cdn/Polyformer/README.md

# Polyformer
## To Reshape, Recreate, Reproduce.

Polyformer is an open-source project that aims to recycle plastics into FDM filaments

Join the Discord by signing up $1 Github sponsorship or $1 Patreon, Link is on the right

Hero_34

Opening_Animation

[Project Page](http://www.reiten.design/polyformer)
