cdn/Polyformer/Electronics/README.md

# Firmware Setup

### Its a good idea to flash the firmware for Pi and MCU **BEFORE** you follow the part 4 video and install them on the machine.

## Option1: (Klipper: Standalone Pi + Compatible MCU)

- Insert SD card into your PC, download and install Pios on the SD card. [Download Pios here](https://www.raspberrypi.com/software/)
- Before you install the OS, please configure your pi's username, password, and network(SSIDs are upper case sensitive!!!) in the setting.
- It takes sometime if the Pi is first time booting up upon an install. Please be patient for 5 minutes and 5 minutes only.



## Klipper installation on Raspberry

First, you’ll need a SSH client such as [PuTTY](https://www.putty.org/) or use your PC’s terminal. We’ll use it to
connect our PC to the Raspberry.

- Start with locating Raspberry in your local network.

  - You can use [Advanced IP Scanner](https://www.advanced-ip-scanner.com/) to find it.

  

  - Or if you can plug a keyboard, a mouse, and a screen to your Raspberry:

    - Once plugged, turn the Raspberry on and wait until the main screen appears
    - Click on the terminal icon on the task bar

    

    - Type `ifconfig` and find the IP address between 192.168.0.1-254 or 192.168.1.1-254

    

- SSH connection

  - If you chose PuTTY, paste the copied IP from the previous step. Click on Open.

  

  - This window may appear, click on Yes

  

  - Then login in the terminal with your username and password.

  * Else, if you chose your PC’s terminal, you can type `ssh pi@192.168.0.210` to connect to the Raspberry ((replace pi by the username you set on Raspberry Setup and the IP by the one you found on the previous step) and type your password.

- GIT installation

  - Type `sudo apt-get install git -y` in the terminal (you might be asked to enter your password)
  - Once the installation is complete, do the followind commands:

    - `cd ~`
    - `git clone https://github.com/th33xitus/kiauh.git`
    - `./kiauh/kiauh.sh`
    - This window will show up

    

    - Use the interface to install Klipper, Moonraker and Mainsail.

## Klipper installation on SKR Pico

If you can't get Klipper working with the UART in Option 2, try the USN which should be easier.

- Option 1 : USB setup



- Option 2 : UART setup



- Build firmware image

   1. SSH into your pi and type
      ```
      cd ~/klipper/
      make menuconfig
      ```

   2. Building the micro controller with the configuration shown below.
      * [*] Enable extra low-level configuration options
      * Micro-controller Architecture = `Raspberry Pi RP2040`
      * IF USE USB
         * Communication interface = `USB`
             klipper_menuconfig
      * ElSE IF USE UART0
         * Communication interface = `Serial (on UART0 GPIO1/GPIO0)`
             

   3. Once the configuration is selected, press `q` to exit,  and "Yes" when  asked to save the configuration.
   4. Run the command `make`
   5. The `klipper.uf2` file will be generated in the folder `home/pi/kliiper/out` when the `make` command completed. Use your windows PC to copy the file from the Pi's folder using [winscp](https://winscp.net/download/WinSCP-5.21.1-Setup.exe) to your PC.

## Firmware Installation

1. Insert a jumper on the `Boot` pins of the motherboard and click the `Reset` button to enter the burn mode (Note: If you want to use USB to power the motherboard, you need to insert a jumper on `USB Power`. When there is 12V / 24V power supply, it is best to remove the jumper)
   boot
2. Connect USB-C to computer, then you will see a USB flash drive named `RPI-PR2`, copy `klipper.uf2` compiled by yourself to the USB flash drive, the motherboard will automatically reboot and update the firmware, the computer will re-identify this USB flash drive means the firmware update
is complete, unplug the `boot jumper` and click the `Reset` button to enter normal working mode

   msc 
3. **(note: this test is only needed for USB configuration)** you can confirm that the flash was successful, by running `ls /dev/serial/by-id`.  if the flash was successful, this should now show a klipper device, similar to:

   rp2040_id

## Configure the printer parameters
### Basic configuration
1. On your PC, open a web browser and go to the IP address we gained for SSH within the same network to access Mainsail.
2. Replace the printer.cfg file from the mainsail interface with [printer.cfg](https://github.com/Reiten966/Polyformer/blob/main/Electronics/Firmware/printer.cfg).
3. If you use USB to communicate with raspberry pi, ssh into the pi and run the `ls /dev/serial/by-id/*` command in raspberry pi to get the correct ID number of the motherboard, and set the correct ID number in `printer.cfg`. And wiring reference [here](#raspberry-pi-is-powered-by-an-external-5v-adapter-and-communicates-with-skr-pico-v10-via-usb)
    ```
    [mcu]
    serial: /dev/serial/by-id/usb-Klipper_rp2040_E66094A027831922-if00
    ```
4. If you use UART0 to communicate with raspberry pi, you need to modify the following files by inserting the SD card into the computer or by SSH command. And wiring reference [here](#raspberry-pi-is-powered-by-the-motherboard-5v-and-communicates-with-skr-pico-v10-via-uart)
   * Remove `console=serial0,115200` in `/boot/cmdline.txt`
   * Add `dtoverlay=pi3-miniuart-bt` at the end of file `/boot/config.txt`
   * Modify the configuration of `[mcu]` in `printer.cfg` to `serial: /dev/ttyAMA0` and enable `restart_method: command` by SSH
     ```
     [mcu]
     serial: /dev/ttyAMA0
     restart_method: command
     ```

## Option2: (Klipper: Voron printer + Compatible MCU)

- Plug the SKR pico to the pi via USB on your printer, and add the polyformer.cfg into your printer's config as below
  
- And then include the polyformer.cfg in your main printer.cfg as below
  

- Follow the Klipper installation on SKR Pico above.

## Option3: (Marlin: Compatible MCU + Screen)

Guide in progress, please ask in the discord.

# Wiring Guide

- UART setup
  Polyformer-Electronics-RPi-SKR-Pico1 0

- USB setup
  

# PID Calibration Procedure

This procedure is for calibrating the heater cartridge.

**Reference documentation**

- [Bigtree SKR Pico v1.0 + RPi setup](https://3dwork.io/en/skr-pico-analysis-and-complete-guide-of-this-great-little-controller)
- [Basic Klipper Configuration](https://3dwork.io/en/skr-pico-analysis-and-complete-guide-of-this-great-little-controller/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)
- [Mainsail](https://docs.mainsail.xyz/)
- [Installing MainsailOS](https://docs.mainsail.xyz/setup/mainsail-os)
- [Klipper3D](https://www.klipper3d.org)

## Pre-reqs

The following instructions assume the following:

- Your hardware setup matches the diagram the provided diagram `Polyformer-Electronics-RPi-SKR-Pico1.0-Working.png`
- Your RaspberryPi has been configured for UART integration. If not, follow this guide [Basic Klipper Configuration](https://3dwork.io/en/skr-pico-analysis-and-complete-guide-of-this-great-little-controller/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)
- _MainsailOS_ (_Mainsail_, _klipper_, and _Moonracker_) are install and running on the _RaspberryPi_
- Your _SKR Pico v1.0_ control board has been flashed with the latest stable firmware and has `UART` support. The name of your firware image should be `klipper-UART0.uf2`
- You are using the attached klipper config `printer.cfg`
- _Mainsail_ web UI is acceesible and there are no errors reported by klipper on the _Mainsail_ dashboard.

**IMPORTANT:** ALL pre-qeqs MUST be satified in order to proceed.

## Instructions

1. Open a web brower and go to the Mainsail website that is running on your RapsberryPi
2. Open the _G-Code console_ on the Mainsail web UI
3. Run the following g-code command to calibrate. This will take about 5 minutes to complete:

```
PID_CALIBRATE HEATER=extruder TARGET=210
```

4. Run this command to save the PID calibration coeffs to the 'printer.cfg' file

```
SAVE_CONFIG
```

5. Click the _Save and Restart_ button to reconfigure _Klipper_
6. Verify temperature stabiity
