cdn/Polyformer/User_Mods/cn#4916/8mm_Bottle_Cap/Bottle_Cap.png

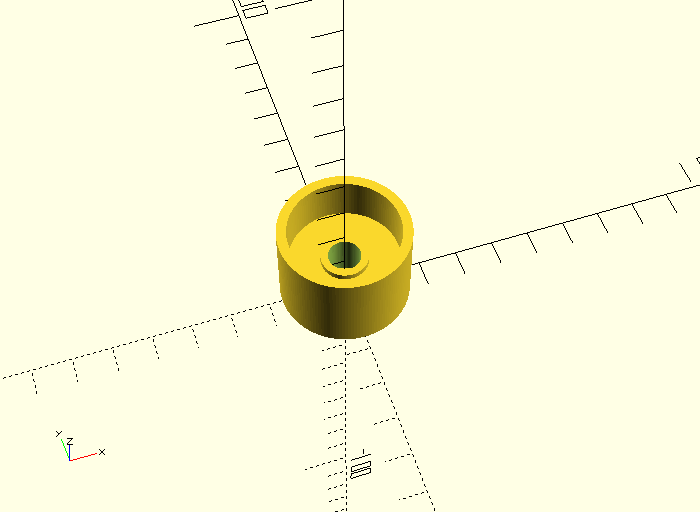
User_Mods/cn#4916/8mm_Bottle_Cap/Bottle_Cap.png
