cdn/Polyformer/STL/Bottle_Cutter (no supports)/Cutter.stl

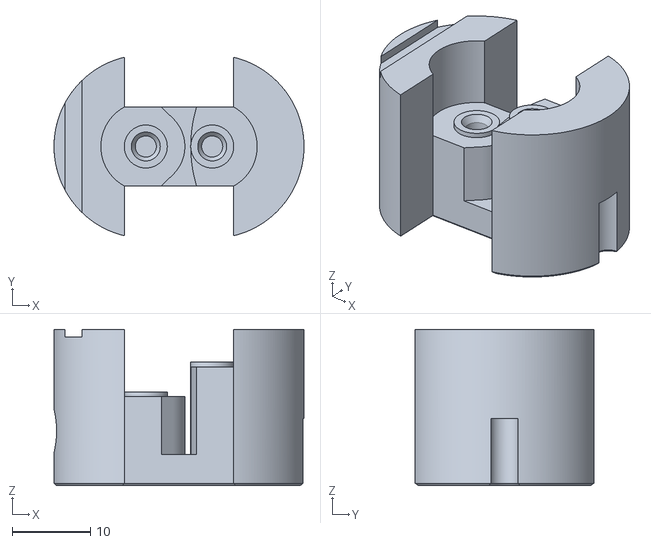
[picture p2: CAD file, 2022-08-05]
STL/Bottle_Cutter (no supports)/Cutter.stl
32.0 x 22.8 x 20.0
