cdn/Polyformer/STL/Carriages_(no supports unless noted)/Ribbon_Cartridge_Cap_2x.stl

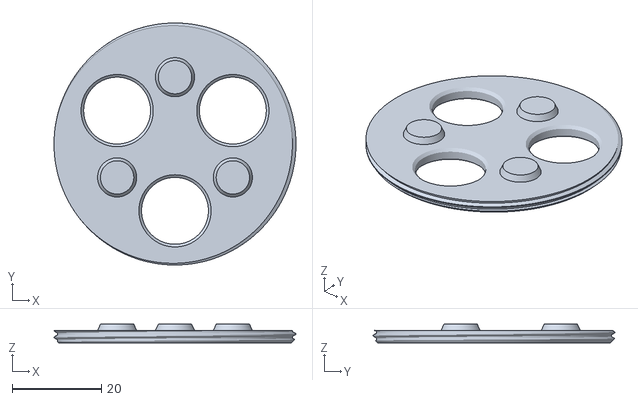
[picture p3: CAD file, 2022-08-05]
STL/Carriages_(no supports unless noted)/Ribbon_Cartridge_Cap_2x.stl
54.3 x 54.3 x 4.20
