cdn/Polyformer/STL/Gearbox (no supports)/Gear_Box_Output_Gear.stl

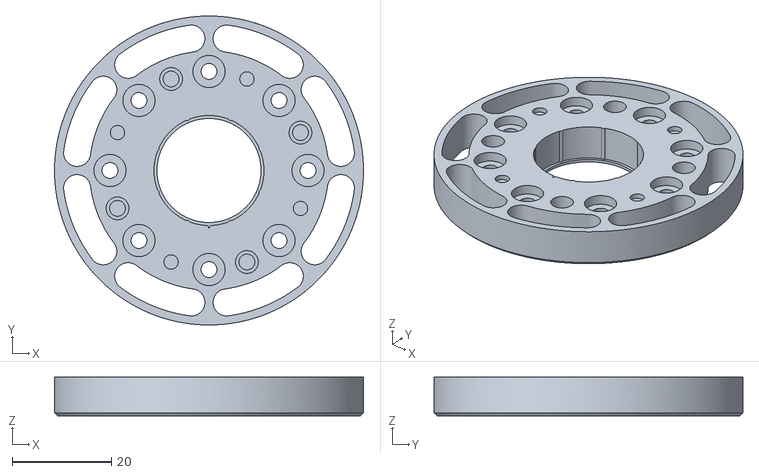
[picture p4: CAD file, 2022-08-05]
STL/Gearbox (no supports)/Gear_Box_Output_Gear.stl
62.4 x 62.4 x 7.80
