cdn/Polyformer/STL/Main_Body (no supports unless noted)/Right_Upper_Arm.stl

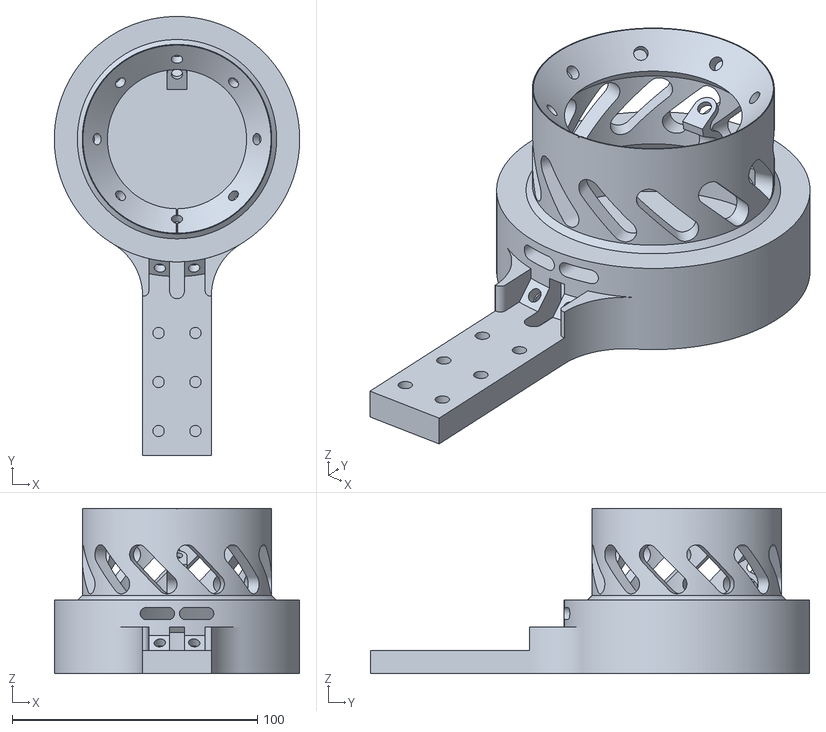
[picture p5: CAD file, 2022-08-05]
STL/Main_Body (no supports unless noted)/Right_Upper_Arm.stl
100.0 x 178.9 x 67.3
