cdn/Polyformer/STL/Panels (no supports unless noted)/Panel_Locks_x8.stl

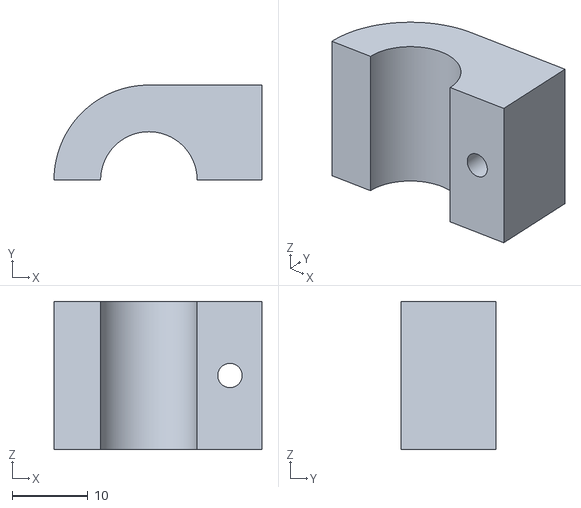
[picture p6: CAD file, 2022-08-05]
STL/Panels (no supports unless noted)/Panel_Locks_x8.stl
27.4 x 12.5 x 19.5
