cdn/Polyformer/STL/Spool (no supports)/[Accent Color] Filament_Mount_Spool_Side.stl

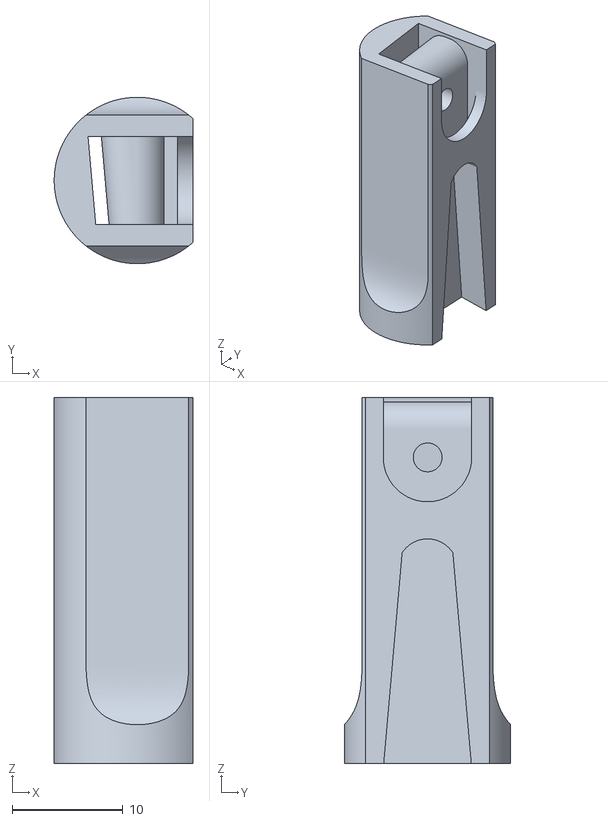
[picture p7: CAD file, 2022-08-05]
STL/Spool (no supports)/[Accent Color] Filament_Mount_Spool_Side.stl
12.5 x 15.0 x 33.0
