cdn/Polyformer/STL/Tools/PolyCube.STL

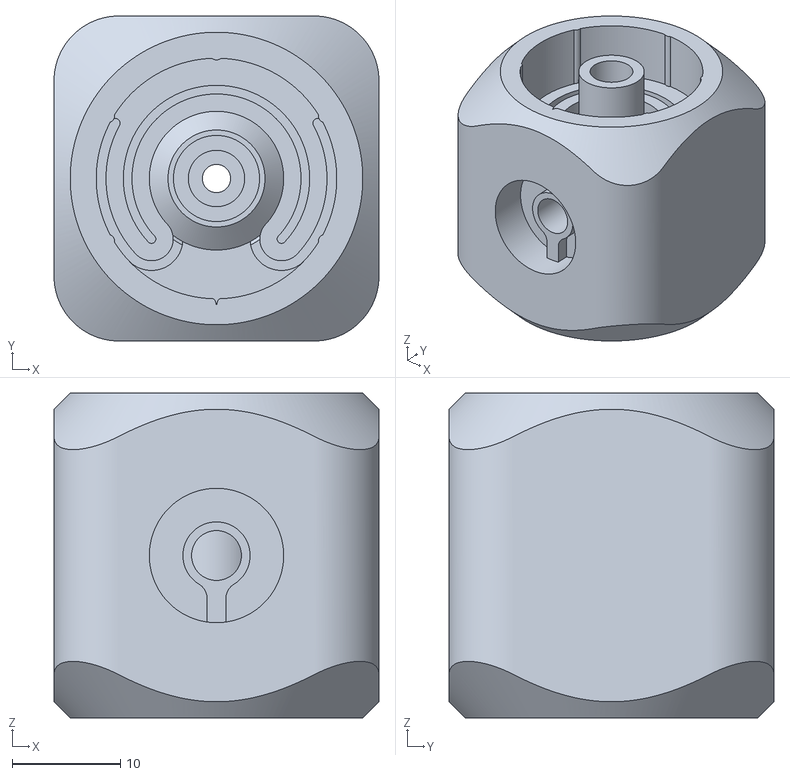
[picture p8: CAD file, 2022-07-15]
STL/Tools/PolyCube.STL
30.0 x 30.0 x 30.0
