cdn/Polyformer/User_Mods/Alextrical#1192/608 Polycutter Lite/15MM Pipe/Bottle_Holder_608_15mmPipe.stl

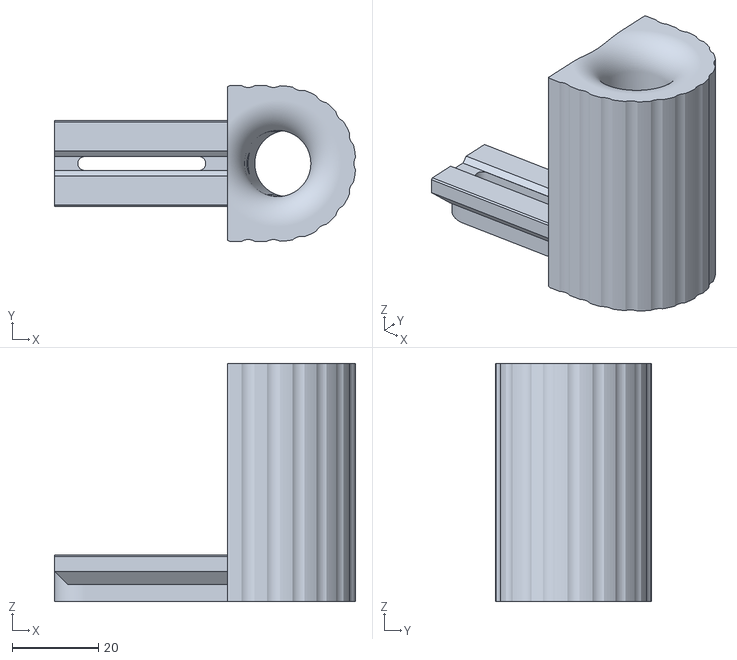
[picture p9: CAD file, 2022-07-15]
User_Mods/Alextrical#1192/608 Polycutter Lite/15MM Pipe/Bottle_Holder_608_15mmPipe.stl
69.6 x 36.0 x 55.2
