cdn/Polyformer/User_Mods/Alextrical#1192/608 Polycutter Lite/8MM Pipe/8mm Bottle Guide.stl

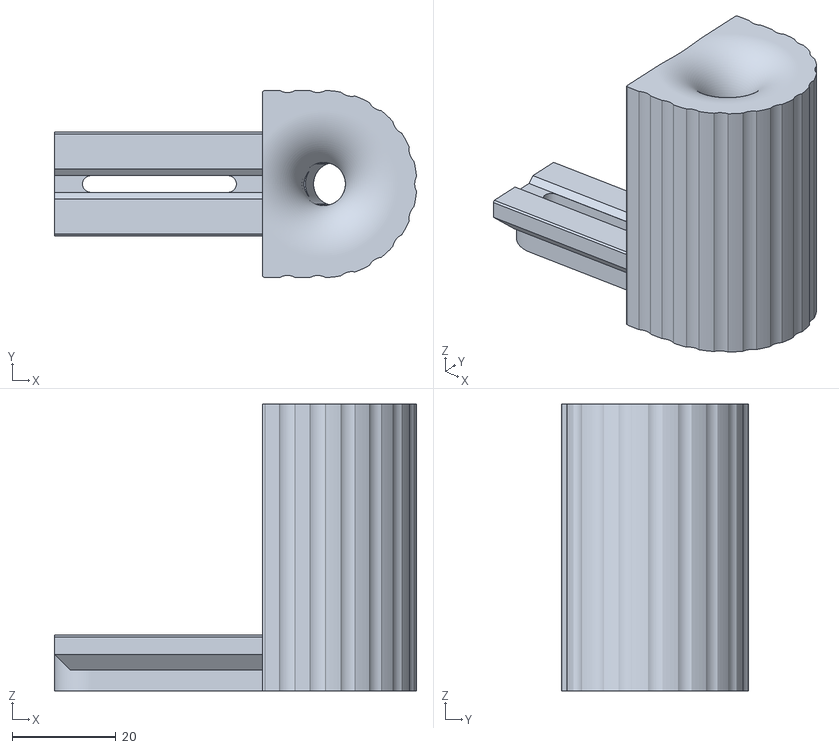
[picture p10: CAD file, 2022-07-15]
User_Mods/Alextrical#1192/608 Polycutter Lite/8MM Pipe/8mm Bottle Guide.stl
69.6 x 36.0 x 55.2
