cdn/Polyformer/User_Mods/Alextrical#1192/608 Polycutter Lite/Sliding_Gauge_608.stl

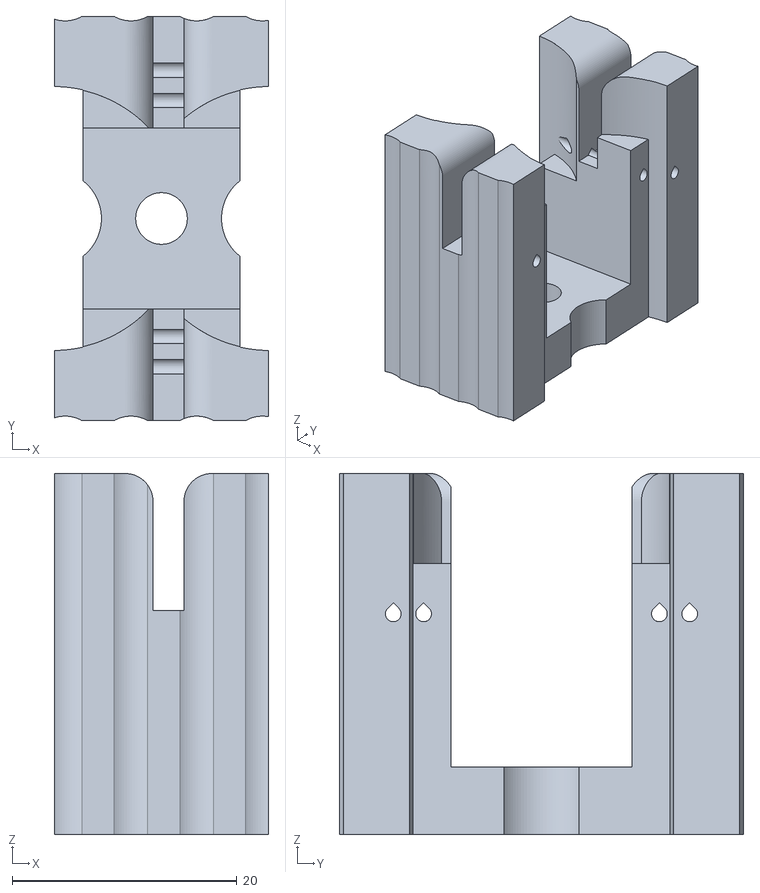
[picture p11: CAD file, 2022-07-15]
User_Mods/Alextrical#1192/608 Polycutter Lite/Sliding_Gauge_608.stl
19.1 x 36.0 x 32.2
