cdn/Polyformer/User_Mods/Alextrical#1192/608 Spool shaft knob/608 Spool Shaft Knob Cap.stl

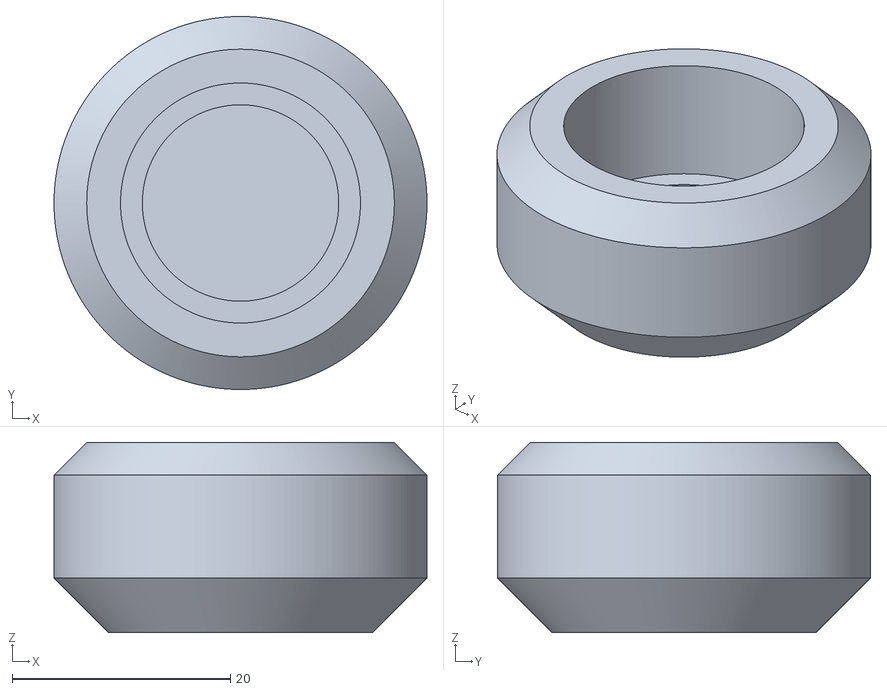
[picture p12: CAD file, 2022-07-15]
User_Mods/Alextrical#1192/608 Spool shaft knob/608 Spool Shaft Knob Cap.stl
34.2 x 34.2 x 17.4
