cdn/Polyformer/User_Mods/Alextrical#1192/Boilerplate/PF007 Dréço Plate.stl

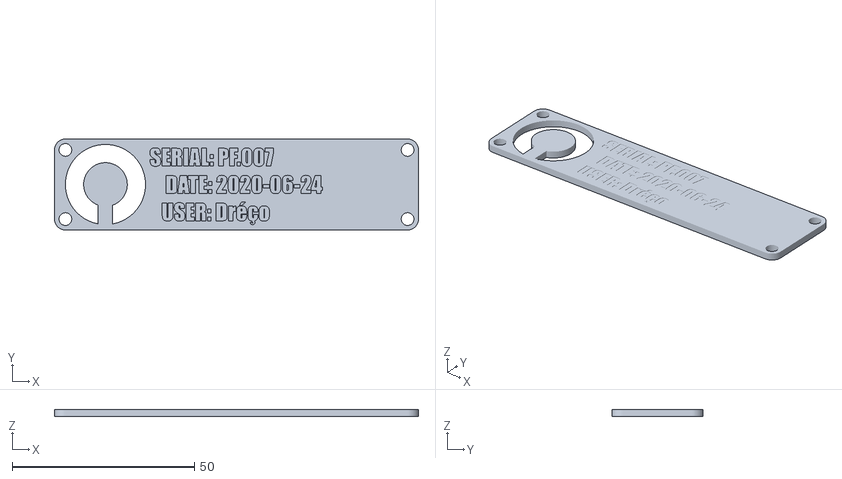
[picture p13: CAD file, 2022-07-15]
User_Mods/Alextrical#1192/Boilerplate/PF007 Dréço Plate.stl
100.0 x 25.0 x 2.00
