cdn/Polyformer/User_Mods/Alextrical#1192/Polycutter Lite/Polycutter Lite_6_17_2022 8mm Bottle Holder.step

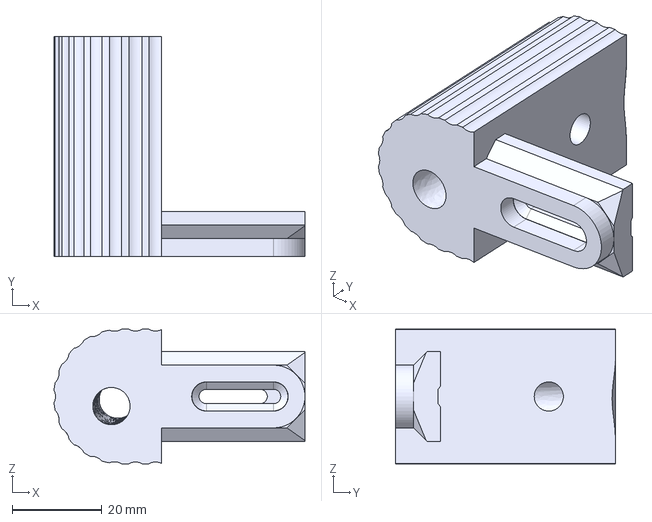
[picture p14: CAD file, 2022-07-15]
User_Mods/Alextrical#1192/Polycutter Lite/Polycutter Lite_6_17_2022 8mm Bottle Holder.step
55.9 x 49.0 x 30.0 mm
