cdn/Polyformer/User_Mods/lhong820#0249/150mm_Metal_Rod_Arm/right_upper_arm_rod_design.stl

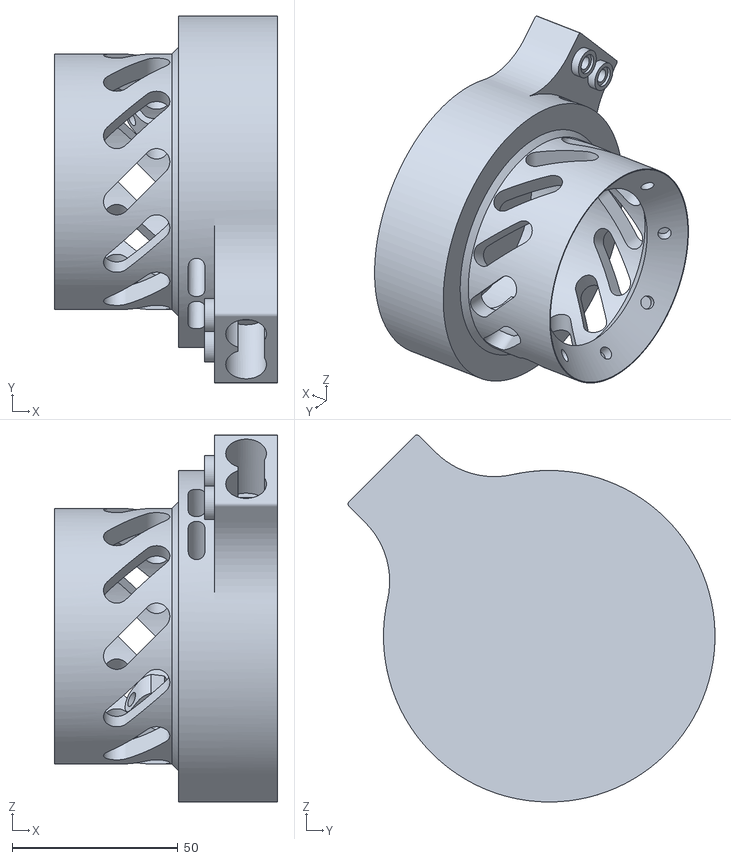
[picture p15: CAD file, 2022-07-15]
User_Mods/lhong820#0249/150mm_Metal_Rod_Arm/right_upper_arm_rod_design.stl
67.3 x 110.7 x 110.7
