cdn/Polyformer/User_Mods/lhong820#0249/BTT_Pico_Mounting_Bracket/pico_bracket.stl

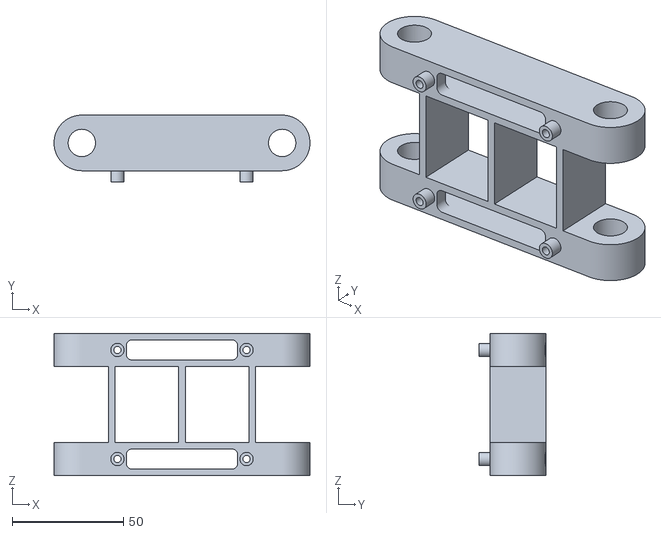
[picture p16: CAD file, 2022-07-15]
User_Mods/lhong820#0249/BTT_Pico_Mounting_Bracket/pico_bracket.stl
115.0 x 30.0 x 64.0
