cdn/Polyformer/STL/Bottle_Cutter (no supports)/Bottle_Holder.stl

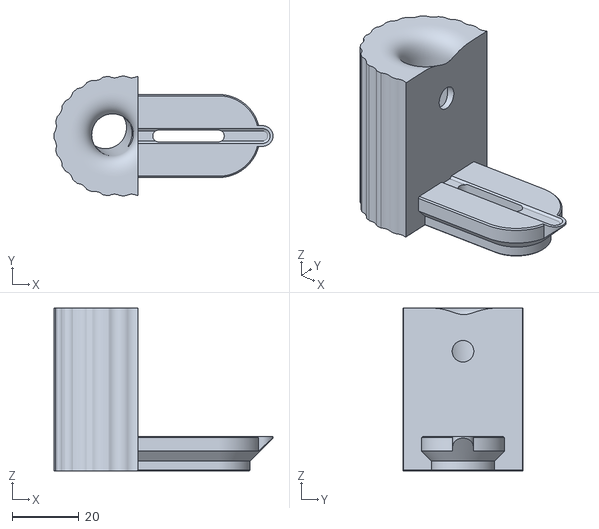
[picture p17: CAD file, 2022-08-05]
STL/Bottle_Cutter (no supports)/Bottle_Holder.stl
65.8 x 36.0 x 49.0
