cdn/Polyformer/STL/Carriages_(no supports unless noted)/Ribbon_Cartridge_Holder.stl

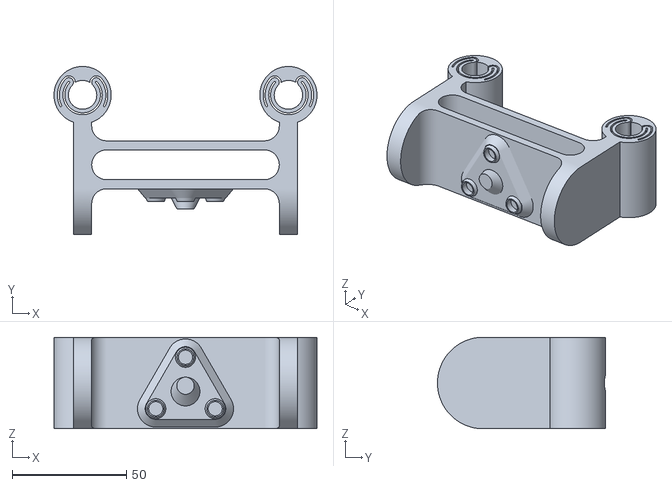
[picture p18: CAD file, 2022-08-05]
STL/Carriages_(no supports unless noted)/Ribbon_Cartridge_Holder.stl
115.0 x 73.5 x 40.0
