cdn/Polyformer/STL/Gearbox (no supports)/Gear_Box_Cap.stl

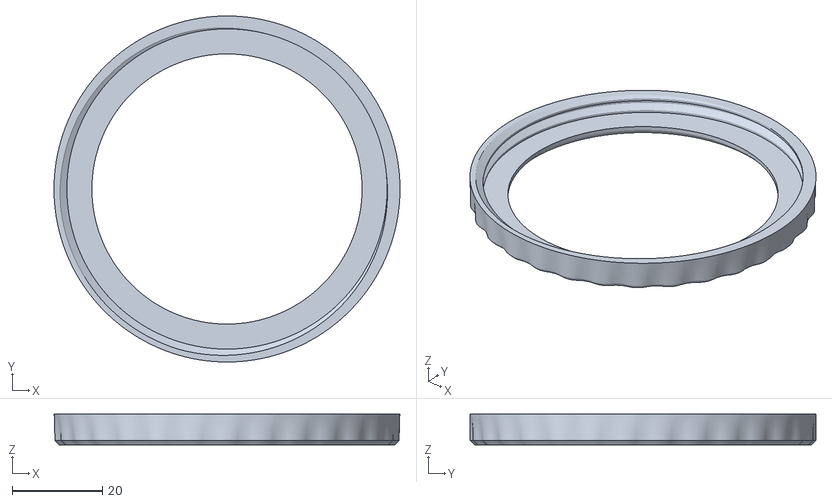
[picture p19: CAD file, 2022-08-05]
STL/Gearbox (no supports)/Gear_Box_Cap.stl
76.8 x 76.8 x 6.85
