cdn/Polyformer/STL/Main_Body (no supports unless noted)/Right_Lower_Arm_(Built-in Supports).stl

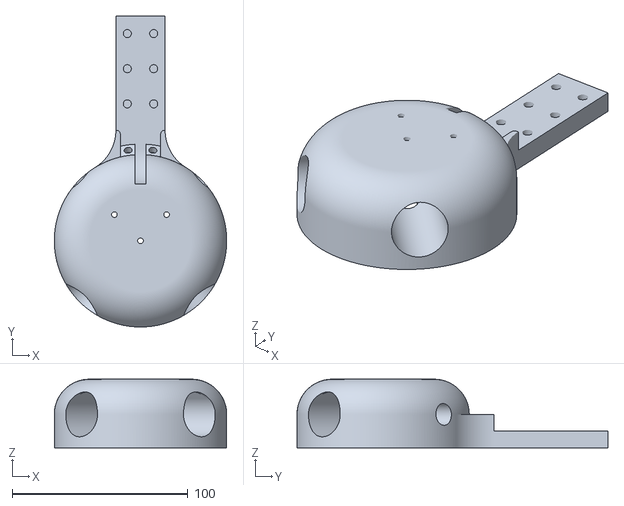
[picture p20: CAD file, 2022-08-05]
STL/Main_Body (no supports unless noted)/Right_Lower_Arm_(Built-in Supports).stl
98.0 x 176.8 x 39.0
