cdn/Polyformer/STL/Panels (no supports unless noted)/Right_Upper_Panel_Second_Half.stl

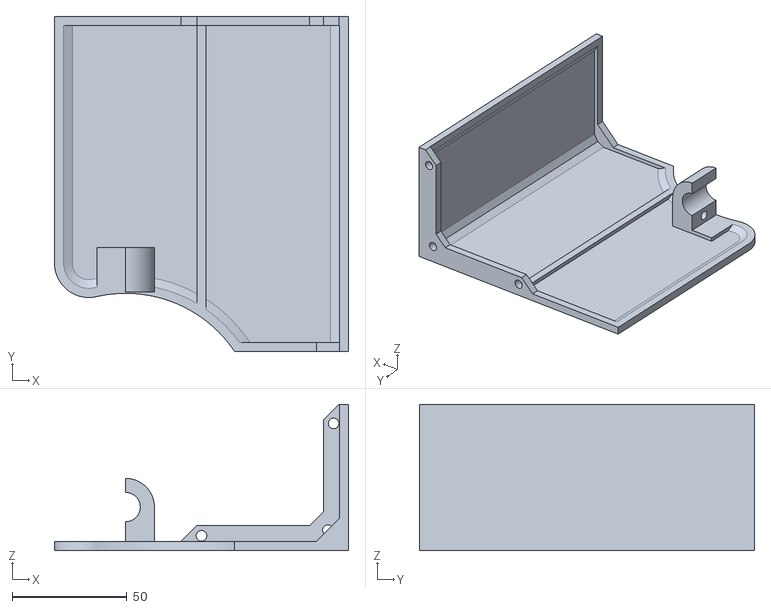
[picture p21: CAD file, 2022-07-15]
STL/Panels (no supports unless noted)/Right_Upper_Panel_Second_Half.stl
128.0 x 145.8 x 63.8
