cdn/Polyformer/STL/Spool (no supports)/[Accent Color] Spool_Shield_Right.stl

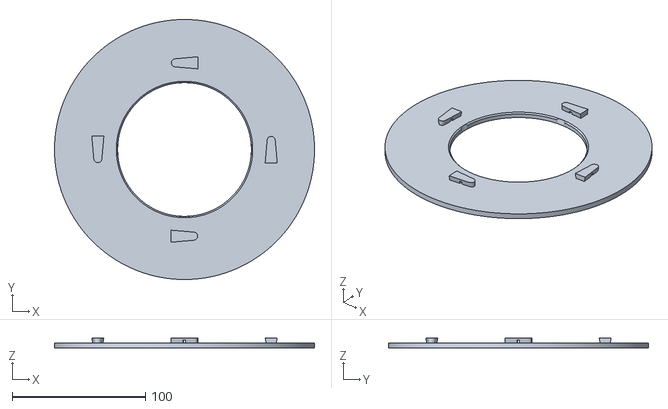
[picture p22: CAD file, 2022-07-15]
STL/Spool (no supports)/[Accent Color] Spool_Shield_Right.stl
195.0 x 195.0 x 7.85
