cdn/Polyformer/STL/Tools/PolyPlane.STL

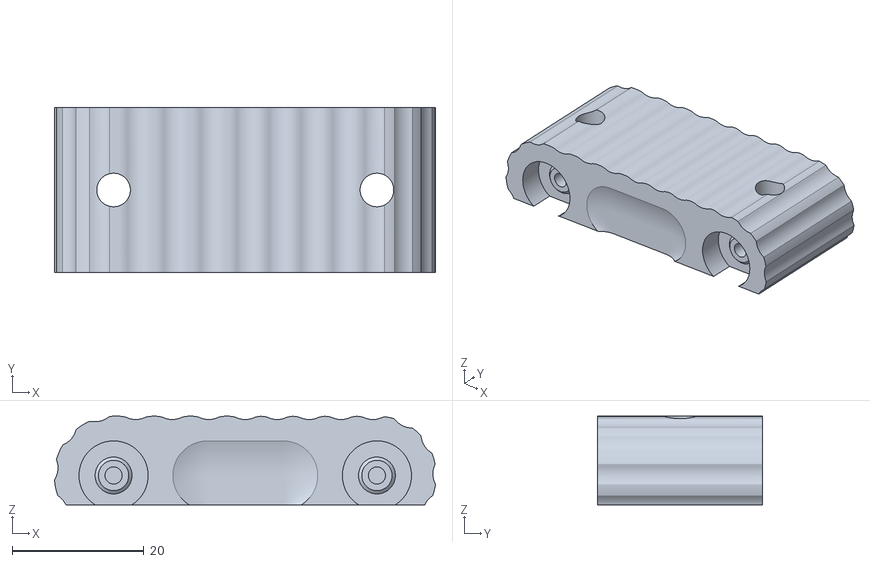
[picture p23: CAD file, 2022-07-15]
STL/Tools/PolyPlane.STL
57.9 x 25.0 x 13.4
