cdn/Polyformer/User_Mods/Alextrical#1192/608 Spool shaft knob/608 Spool Shaft Knob Spindle.stl

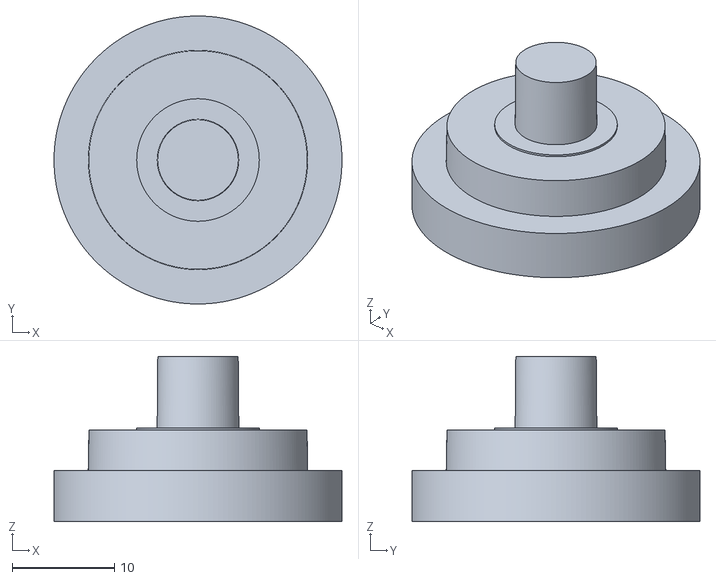
[picture p24: CAD file, 2022-07-15]
User_Mods/Alextrical#1192/608 Spool shaft knob/608 Spool Shaft Knob Spindle.stl
28.2 x 28.2 x 16.2
