cdn/Polyformer/User_Mods/Alextrical#1192/Boilerplate/PF007 Dréço Imprint.stl

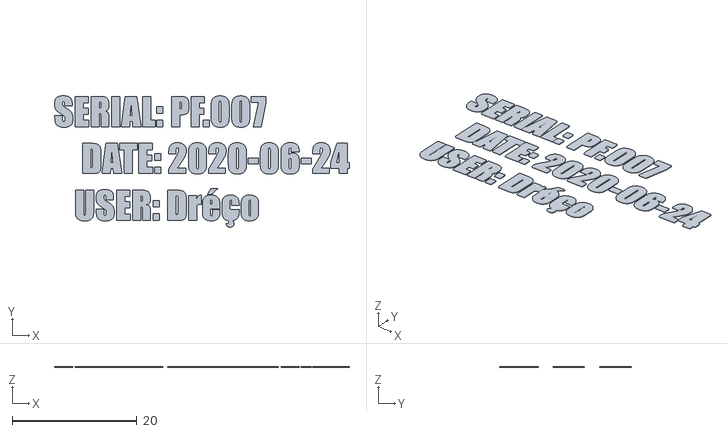
[picture p25: CAD file, 2022-07-15]
User_Mods/Alextrical#1192/Boilerplate/PF007 Dréço Imprint.stl
47.4 x 21.1 x 0.2
