cdn/Polyformer/User_Mods/Alextrical#1192/Polycutter Lite/Bottle Holder 8mm.stl

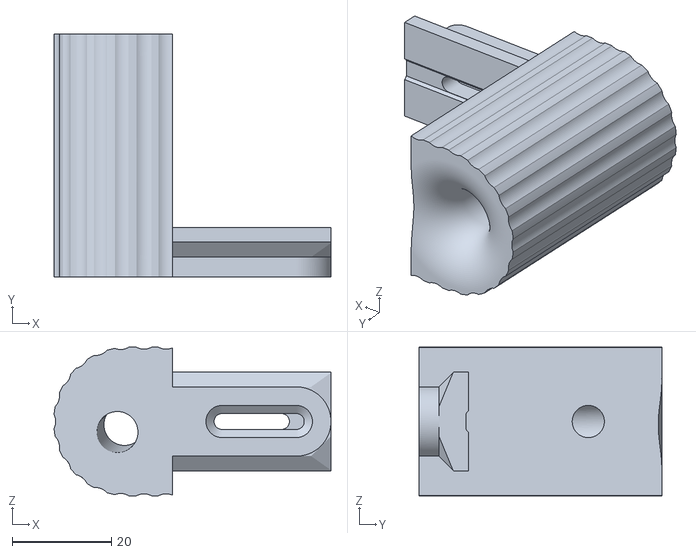
[picture p26: CAD file, 2022-07-15]
User_Mods/Alextrical#1192/Polycutter Lite/Bottle Holder 8mm.stl
55.9 x 49.0 x 30.0
