cdn/Polyformer/User_Mods/lhong820#0249/150mm_Metal_Rod_Arm/right_lower_arm_rod_design.stl

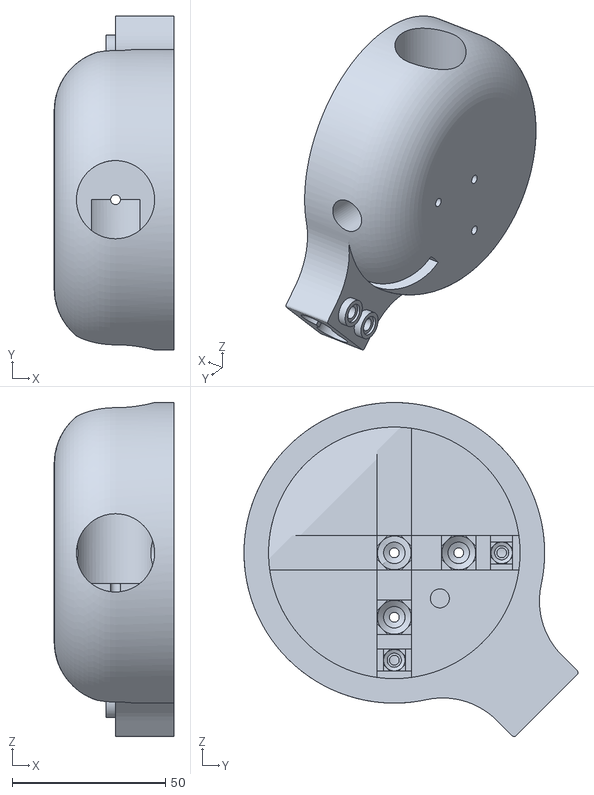
[picture p27: CAD file, 2022-07-15]
User_Mods/lhong820#0249/150mm_Metal_Rod_Arm/right_lower_arm_rod_design.stl
39.0 x 108.9 x 108.9
