cdn/Polyformer/STL/Bottle_Cutter (no supports)/Sliding_Gauge.stl

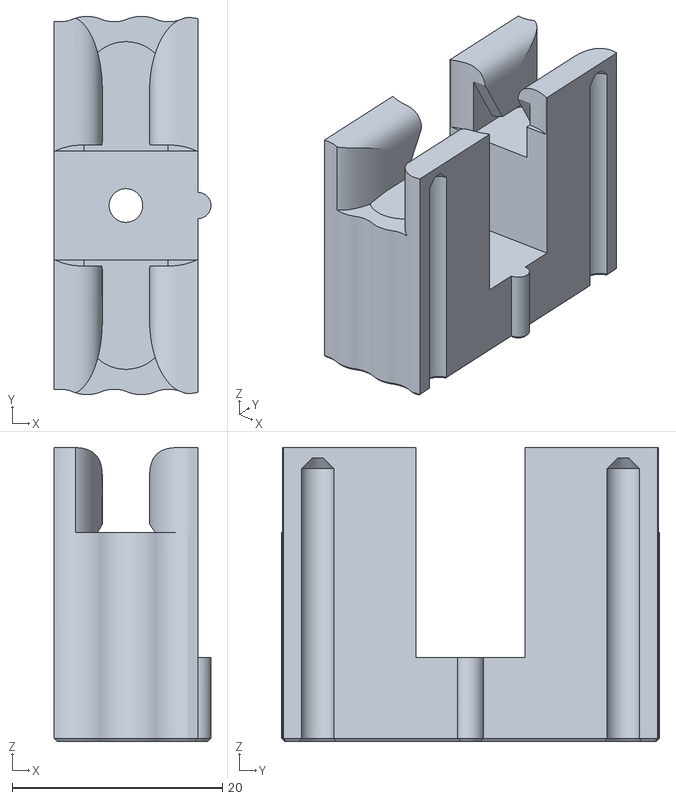
[picture p28: CAD file, 2022-08-05]
STL/Bottle_Cutter (no supports)/Sliding_Gauge.stl
15.0 x 36.0 x 28.0
