cdn/Polyformer/STL/Carriages_(no supports unless noted)/Meltzone_Guidler_(Placeholder).stl

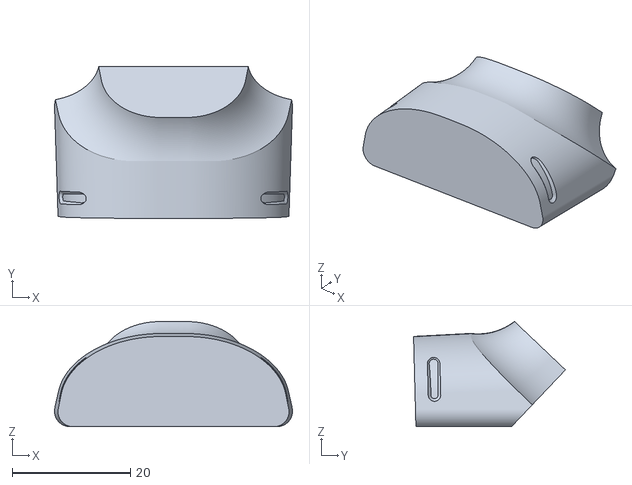
[picture p29: CAD file, 2022-07-15]
STL/Carriages_(no supports unless noted)/Meltzone_Guidler_(Placeholder).stl
40.3 x 25.7 x 17.8
