cdn/Polyformer/STL/Gearbox (no supports)/Gear_Box_CAM.stl

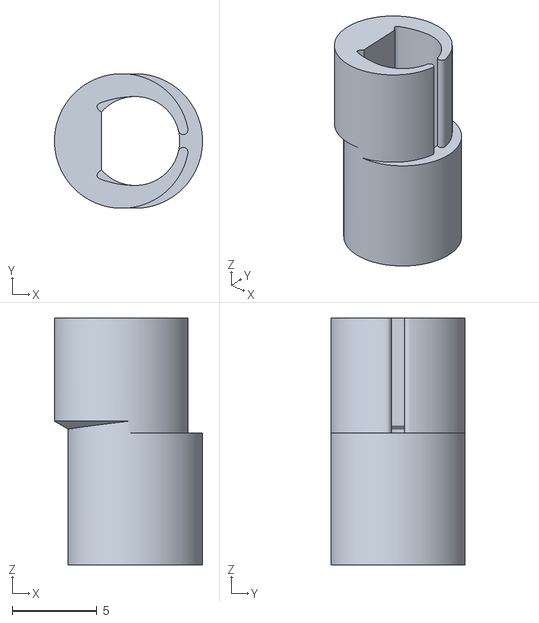
[picture p30: CAD file, 2022-08-05]
STL/Gearbox (no supports)/Gear_Box_CAM.stl
8.75 x 7.95 x 14.6
