cdn/Polyformer/STL/Main_Body (no supports unless noted)/[Accent Color] Trim_Plate_x2.stl

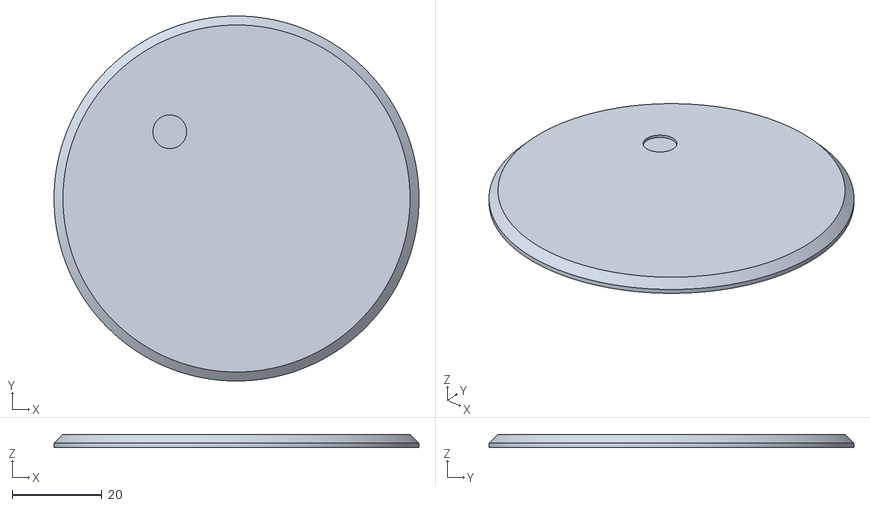
[picture p31: CAD file, 2022-08-05]
STL/Main_Body (no supports unless noted)/[Accent Color] Trim_Plate_x2.stl
81.2 x 81.2 x 3.00
