cdn/Polyformer/STL/Spool (no supports)/[Accent Color] Spool_Shield_Left.stl

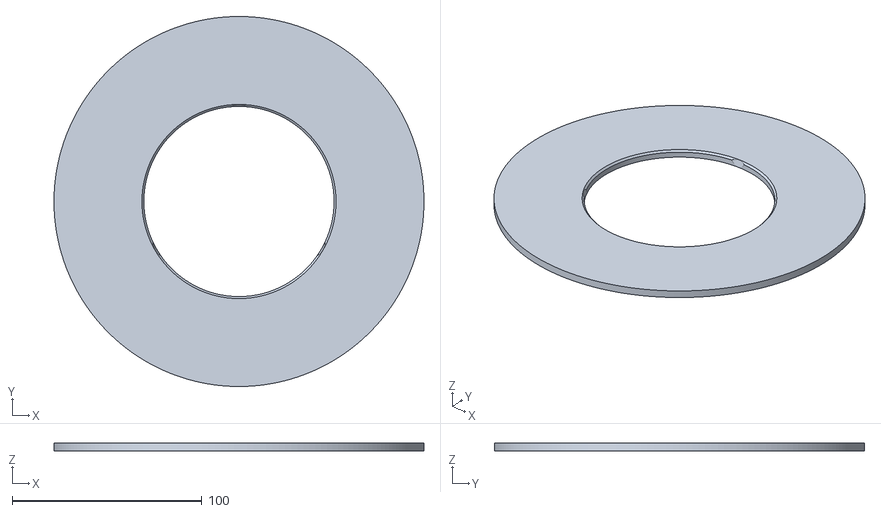
[picture p32: CAD file, 2022-07-15]
STL/Spool (no supports)/[Accent Color] Spool_Shield_Left.stl
195.0 x 195.0 x 4.00
