cdn/Polyformer/STL/Tools/Mini_Polyformer.STL

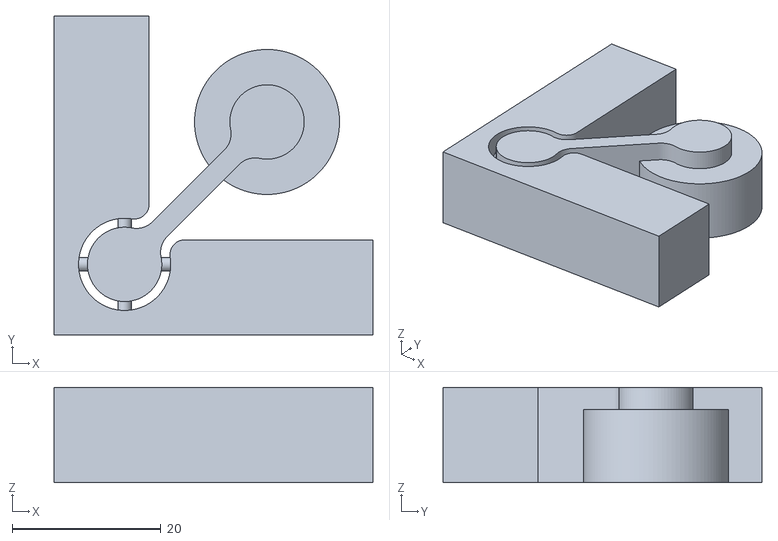
[picture p33: CAD file, 2022-07-15]
STL/Tools/Mini_Polyformer.STL
42.9 x 42.9 x 12.8
