cdn/Polyformer/User_Mods/Alextrical#1192/608 Polycutter Lite/Cutter_608.stl

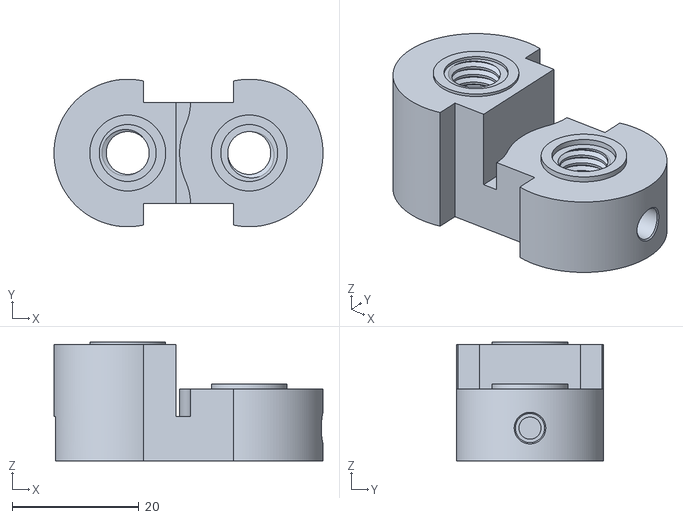
[picture p34: CAD file, 2022-07-15]
User_Mods/Alextrical#1192/608 Polycutter Lite/Cutter_608.stl
42.5 x 23.3 x 18.8
