cdn/Polyformer/STL/Bottle_Cutter (no supports)/Body.stl

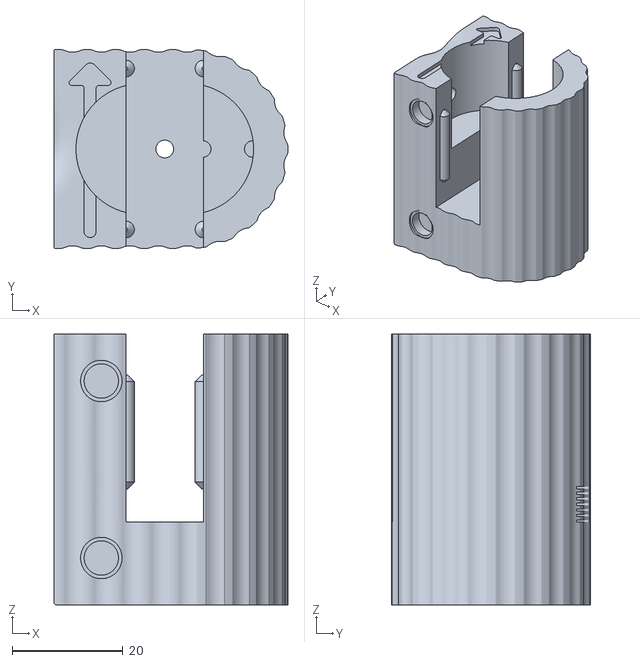
[picture p35: CAD file, 2022-08-05]
STL/Bottle_Cutter (no supports)/Body.stl
42.2 x 36.0 x 49.0
