cdn/Polyformer/STL/Carriages_(no supports unless noted)/Meltzone_Wings_2x.stl

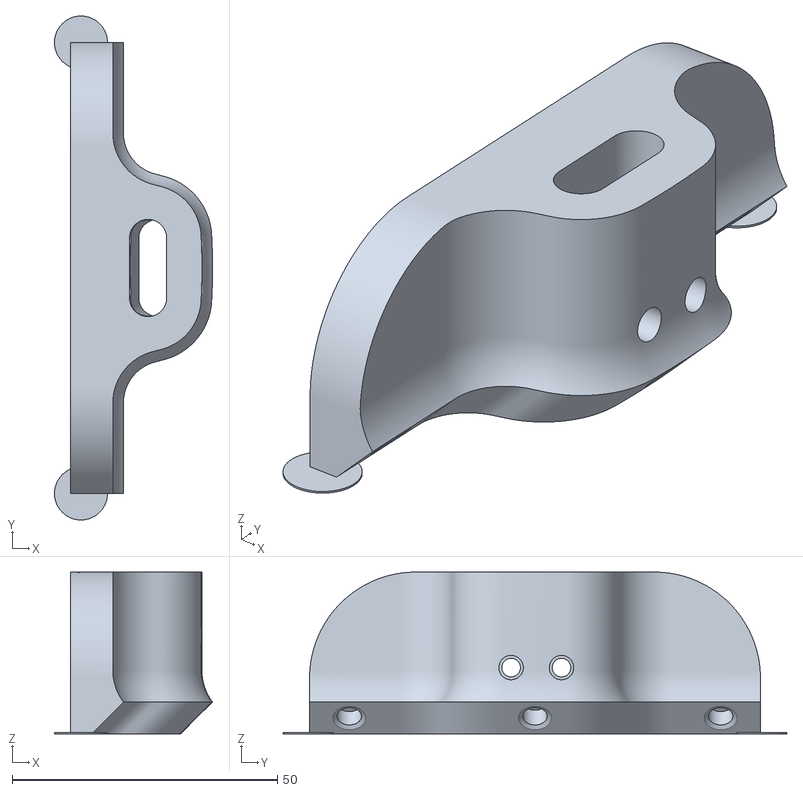
[picture p36: CAD file, 2022-07-15]
STL/Carriages_(no supports unless noted)/Meltzone_Wings_2x.stl
29.8 x 95.0 x 30.5
