cdn/Polyformer/STL/Gearbox (no supports)/Gear_Box_Ring_Gear.stl

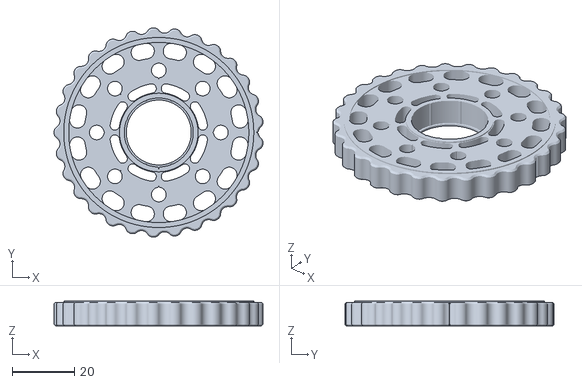
[picture p37: CAD file, 2022-07-15]
STL/Gearbox (no supports)/Gear_Box_Ring_Gear.stl
67.3 x 67.4 x 8.00
