cdn/Polyformer/STL/Main_Body (no supports unless noted)/[Accent Color] Spool_Shaft_Knob.stl

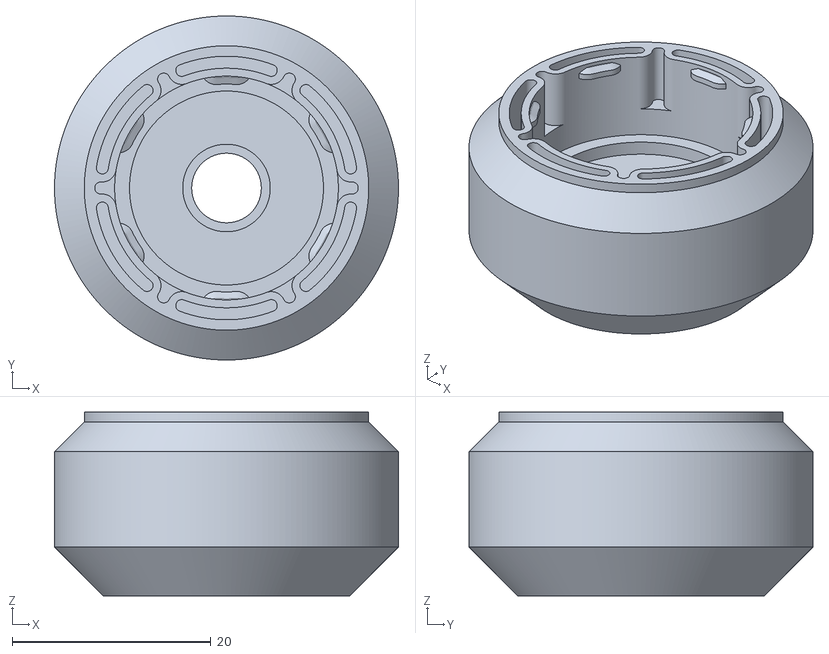
[picture p38: CAD file, 2022-08-05]
STL/Main_Body (no supports unless noted)/[Accent Color] Spool_Shaft_Knob.stl
34.6 x 34.6 x 18.5
