cdn/Polyformer/User_Mods/Alextrical#1192/608 Polycutter Lite/Bearing cutter v1.3.step

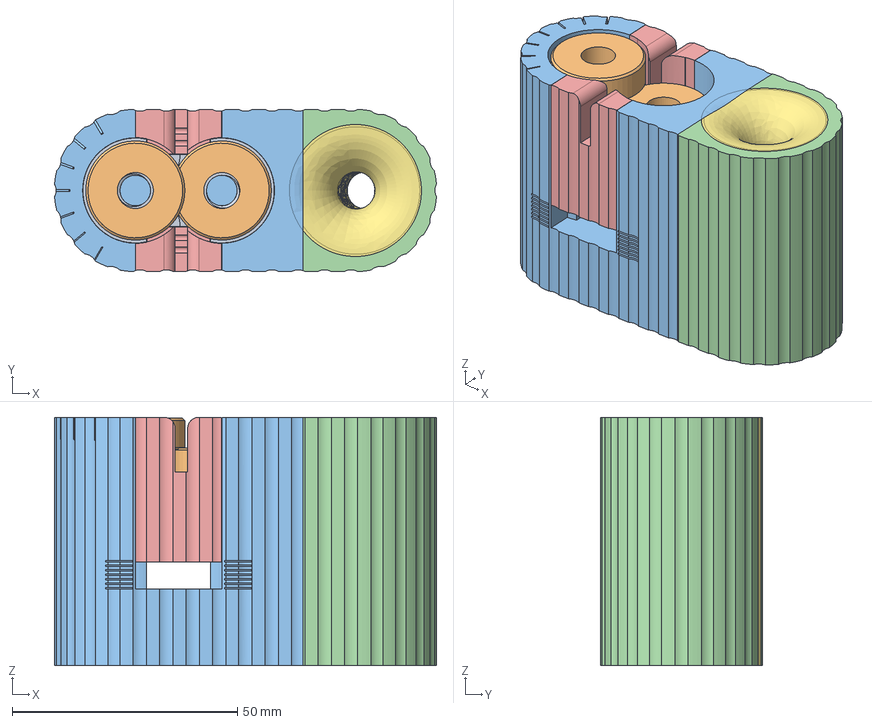
[picture p39: CAD file, 2022-07-15]
User_Mods/Alextrical#1192/608 Polycutter Lite/Bearing cutter v1.3.step
84.8 x 36.0 x 55.1 mm
Cutter608
BottleHolder608 15mm
SlidingGuage608
BottleHolder608 12mm
BottleHolder608 8mm
