cdn/Polyformer/STL/Bottle_Cutter (no supports)/Bottle_Cap.STL

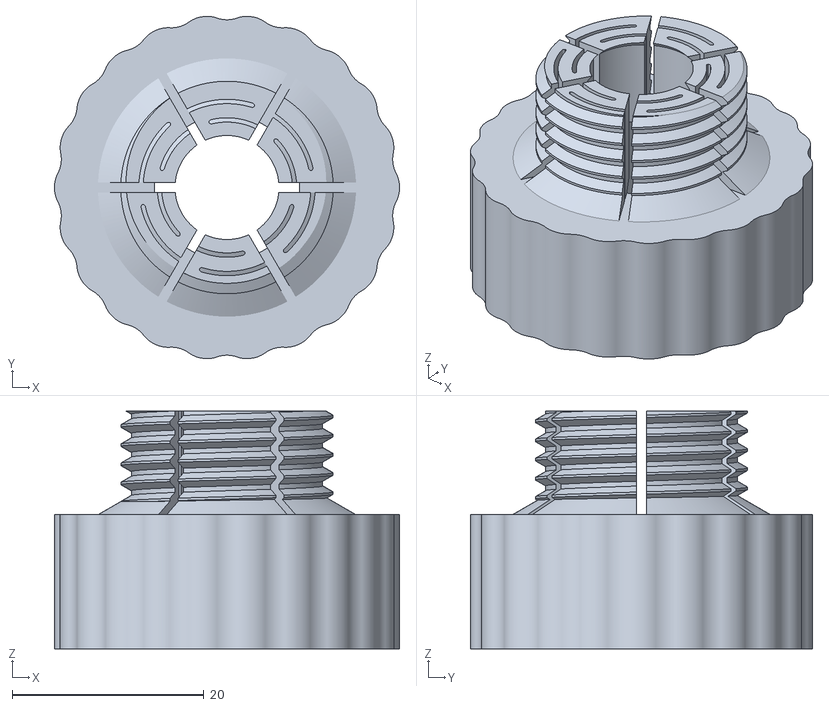
[picture p40: CAD file, 2022-07-15]
STL/Bottle_Cutter (no supports)/Bottle_Cap.STL
36.0 x 35.7 x 24.8
