cdn/Polyformer/STL/Carriages_(no supports unless noted)/Outlet.stl

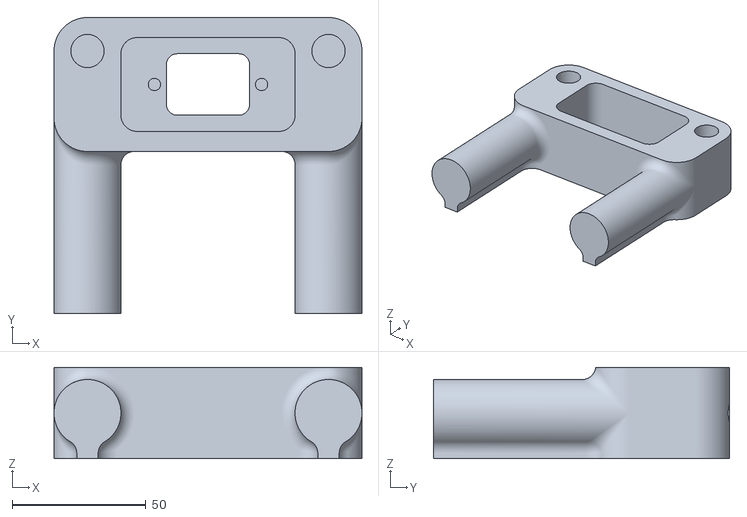
[picture p41: CAD file, 2022-07-15]
STL/Carriages_(no supports unless noted)/Outlet.stl
115.0 x 110.5 x 34.0
