cdn/Polyformer/User_Mods/Alextrical#1192/608 Polycutter Lite/Body_608.stl

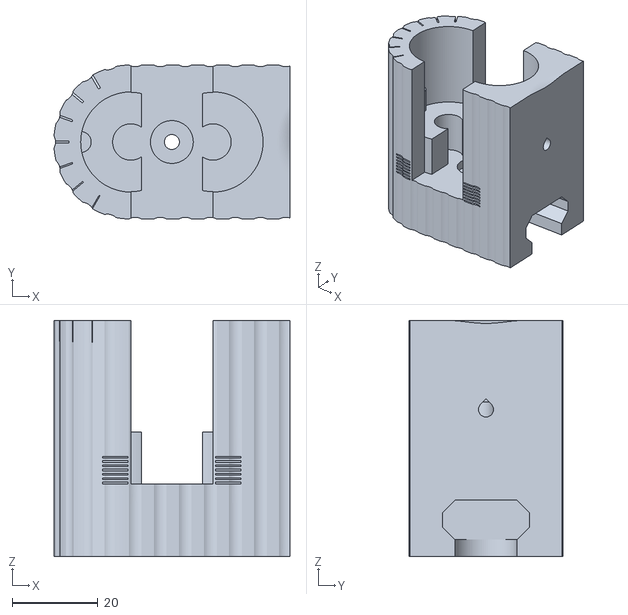
[picture p42: CAD file, 2022-07-15]
User_Mods/Alextrical#1192/608 Polycutter Lite/Body_608.stl
55.1 x 36.0 x 55.2
