cdn/Polyformer/STL/Bottle_Cutter (no supports)/Bottle_Cap_Tensioner.STL

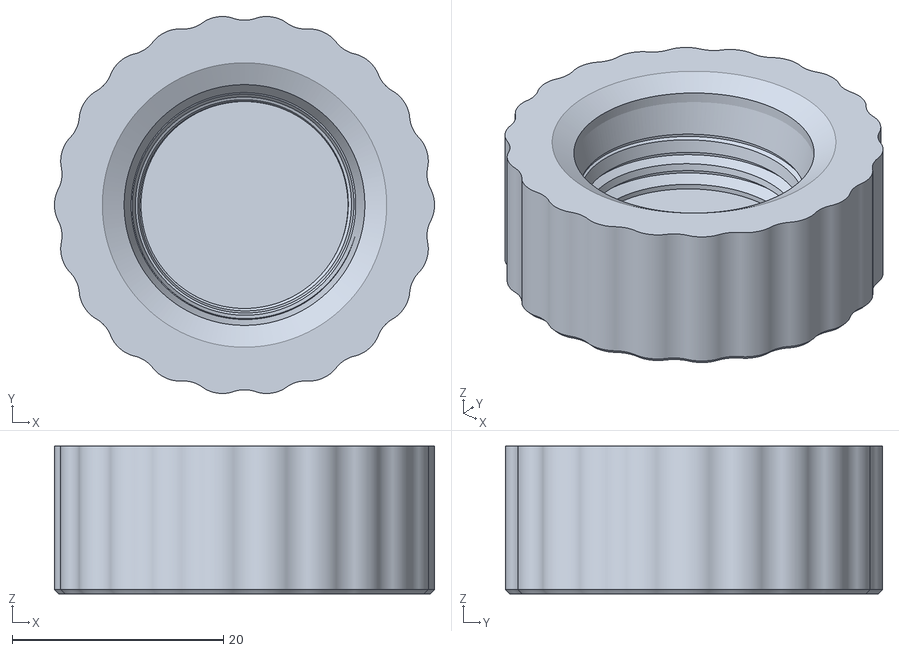
[picture p43: CAD file, 2022-07-15]
STL/Bottle_Cutter (no supports)/Bottle_Cap_Tensioner.STL
36.0 x 35.7 x 14.0
