cdn/Polyformer/STL/Main_Body (no supports unless noted)/[Accent Color] Spool_Shaft_Knob_Tensioner.stl

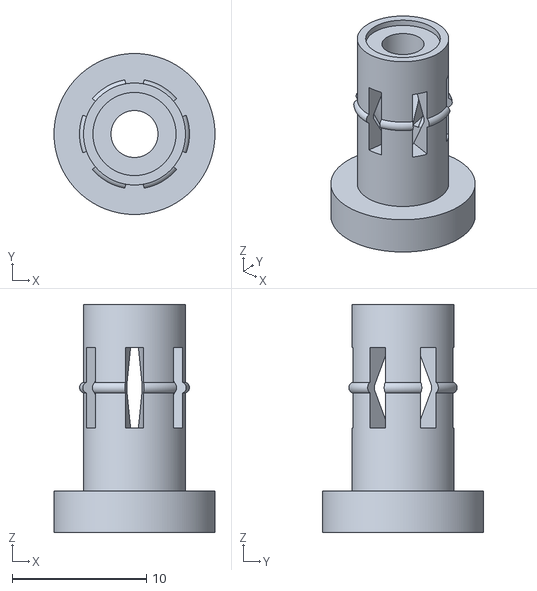
[picture p44: CAD file, 2022-07-15]
STL/Main_Body (no supports unless noted)/[Accent Color] Spool_Shaft_Knob_Tensioner.stl
12.0 x 12.0 x 17.0
