cdn/Polyformer/STL/Main_Body (no supports unless noted)/Feet_x2.stl

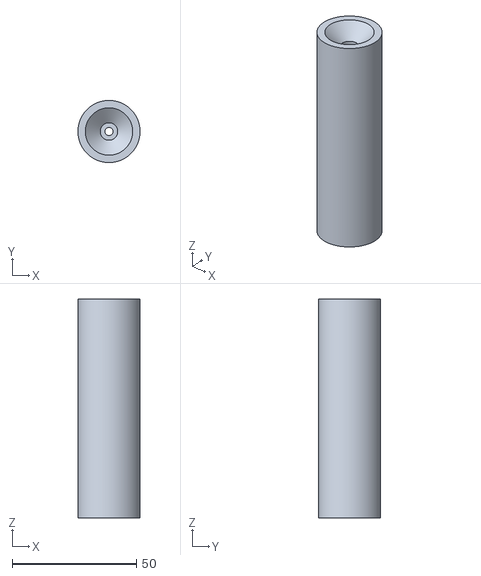
[picture p45: CAD file, 2022-07-15]
STL/Main_Body (no supports unless noted)/Feet_x2.stl
25.0 x 25.0 x 88.0
