cdn/Polyformer/STL/Main_Body (no supports unless noted)/Right_Arm_Connector.stl

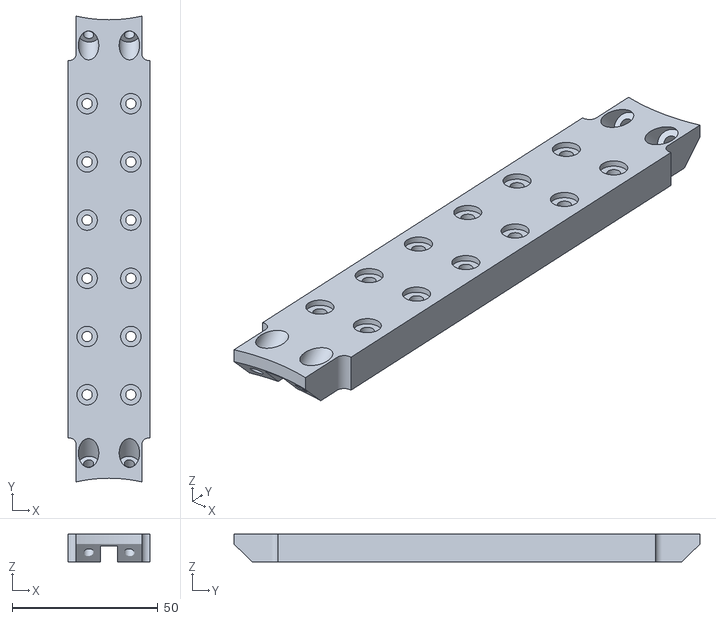
[picture p46: CAD file, 2022-07-15]
STL/Main_Body (no supports unless noted)/Right_Arm_Connector.stl
28.0 x 159.9 x 9.50
