cdn/Polyformer/STL/Main_Body (no supports unless noted)/Left_Upper_Arm_(Built-in Supports).stl

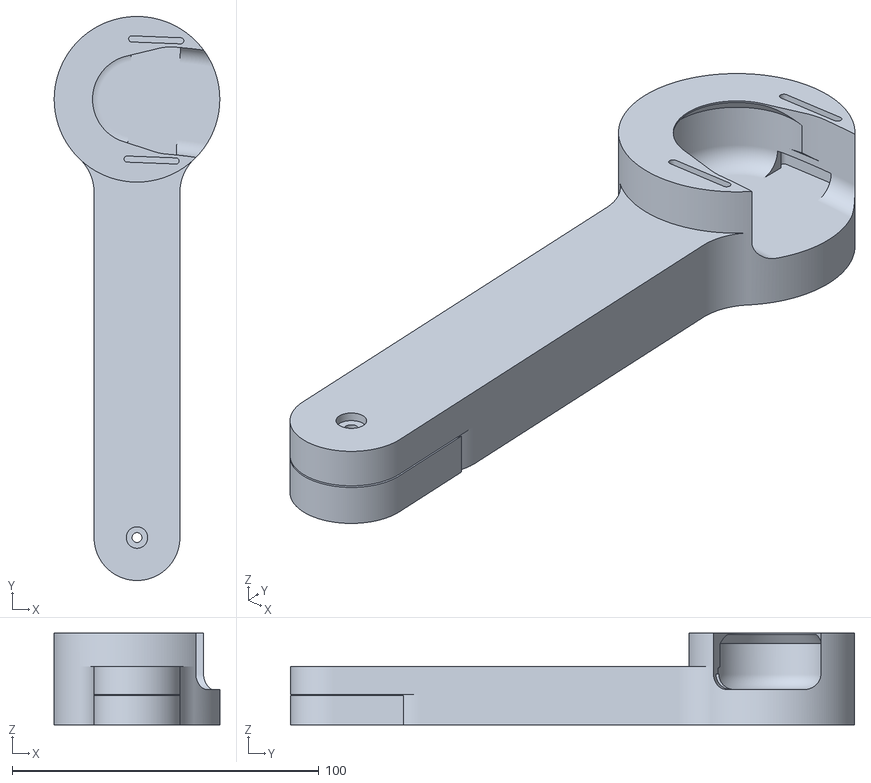
[picture p47: CAD file, 2022-07-15]
STL/Main_Body (no supports unless noted)/Left_Upper_Arm_(Built-in Supports).stl
54.0 x 183.9 x 29.9
