cdn/Polyformer/(list of files, cad)

Other CAD files:
User_Mods/Alextrical#1192/608 Polycutter Lite/Bottle_Holder_608.stl
STL/Main_Body (no supports unless noted)/Left_Lower_Arm_(Built-in Supports).stl
STL/Main_Body (no supports unless noted)/Right_Arm_Connector_Retrofit_Previous_Release.stl
