cdn/Polyformer/Build Guide/README.md

# Video Guides

[Polyformer assembly video part 1](https://www.youtube.com/watch?v=gqaRRzHKmp0)

[Polyformer assembly video part 2](https://youtu.be/Hwx7r2c6wwA)

[Polyformer assembly video part 3](https://www.youtube.com/watch?v=d54wQbAX7XY&t=61s)

[Polyformer assembly video part 4](https://youtu.be/LeM5dLHGVpM)

[Bottle cutter assembly video (Needs update)](https://www.youtube.com/watch?v=mIvZ6ZM0HBI)

Andromeda updates needs new assembly videos which is still in the works.

Please refer to the Assembly Guides made by @lhong820#0249 for assembly.
