cdn/Polyformer/Build Guide/electronics_bracket_assembly.pdf

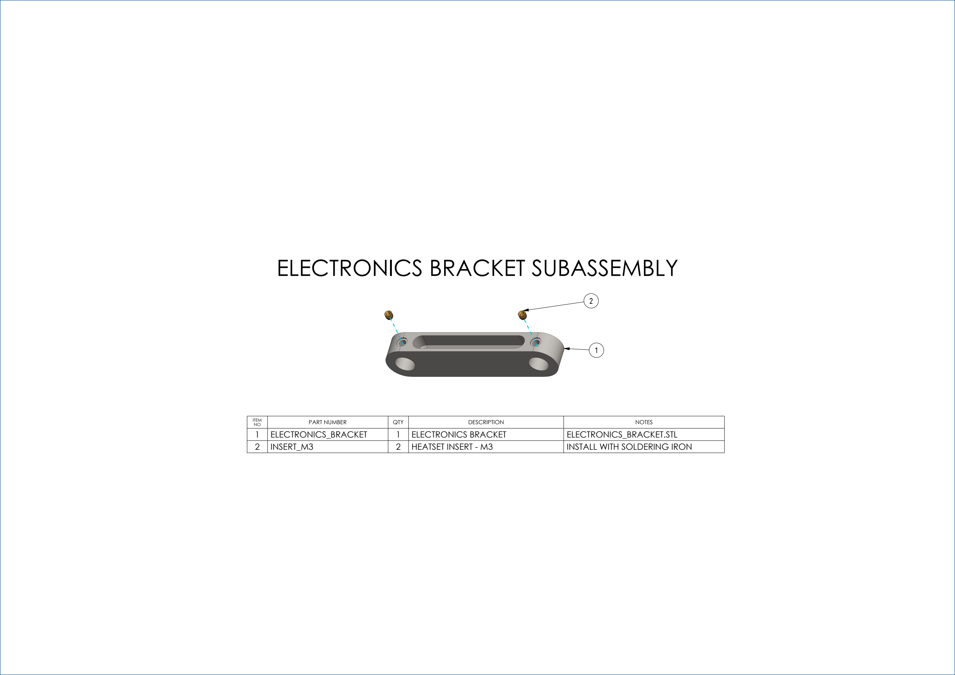
[picture p48: figure]
ITEM NO; PART NUMBER; QTY; DESCRIPTION; NOTES; ELECTRONICS_BRACKET; ELECTRONICS BRACKET; ELECTRONICS_BRACKET.STL; INSERT_M3; HEATSET INSERT - M3; INSTALL WITH SOLDERING IRON; ELECTRONICS BRACKET SUBASSEMBLY
