cdn/Polyformer/Build Guide/filament_guidler_assembly.pdf

ITEM NO | PART NUMBER | QTY | DESCRIPTION | NOTES
1 | FILAMENT_GUIDLER | 1 | FILAMENT GUIDLER | FILAMENT_GUIDLER.STL
2 | INSERT_M3 | 2 | HEATSET INSERT - M3 | INSTALL WITH SOLDERING IRON
3 | BEARING_623-2Z | 1 | BEARING 623-2Z | INSTALL AS SHOWN
4 | BHCS_M3_8MM | 1 | BUTTON HEAD CAP SCREW - M3 X 8mm | INSTALL AS SHOWN

# FILAMENT GUIDLER SUBASSEMBLY

3

4

1 | 2
