cdn/Polyformer/Build Guide/frame_bracket_assembly.pdf

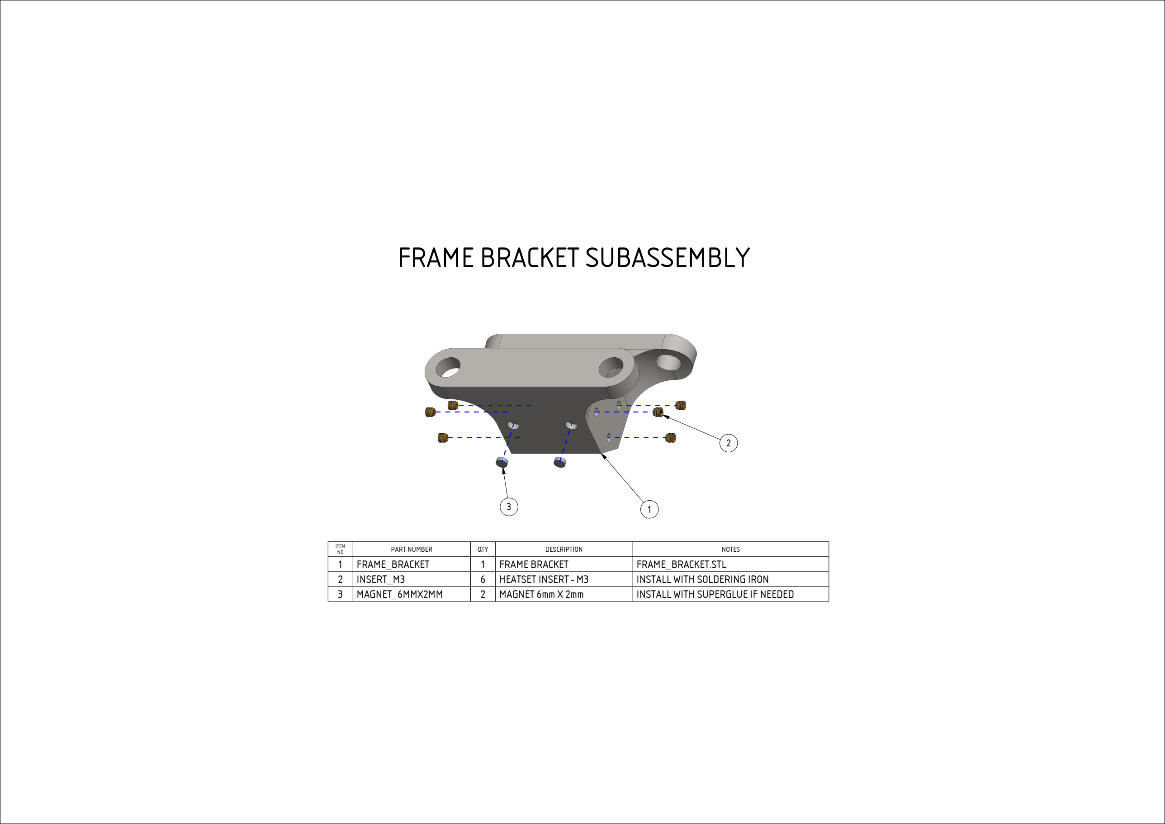
[picture p49: figure]
ITEM NO; PART NUMBER; QTY; DESCRIPTION; NOTES; FRAME_BRACKET; FRAME BRACKET; FRAME_BRACKET.STL; INSERT_M3; HEATSET INSERT - M3; INSTALL WITH SOLDERING IRON; MAGNET_6MMX2MM; MAGNET 6mm X 2mm; INSTALL WITH SUPERGLUE IF NEEDED; FRAME BRACKET SUBASSEMBLY
