cdn/Polyformer/Build Guide/gearbox_output_gear_assembly.pdf

ITEM NO | PART NUMBER | QTY | DESCRIPTION | NOTES
1 | GEARBOX_OUTPUT_GEAR | 1 | GEARBOX OUTPUT GEAR | GEAR_BOX_OUTPUT_GEAR.STL
2 | BEARING_608-2RS | 1 | BEARING 608-2RS | PRESS INTO CENTER OF OUTPUT GEAR
3 | BHCS_M3_12MM | 8 | BUTTON HEAD CAP SCREW - M3 X 12mm | INSTALL AS SHOWN ABOVE
4 | INSERT_M3 | 4 | HEATSET INSERT - M3 | INSTALL WITH SOLDERING IRON
5 | NUT_M3 | 8 | HEX NUT - M3 | INSTALL AS SHOWN ABOVE

# GEARBOX OUTPUT GEAR SUBASSEMBLY

1 | 4 | 3 | 2 5
