cdn/Polyformer/Build Guide/left_lower_arm_assembly.pdf

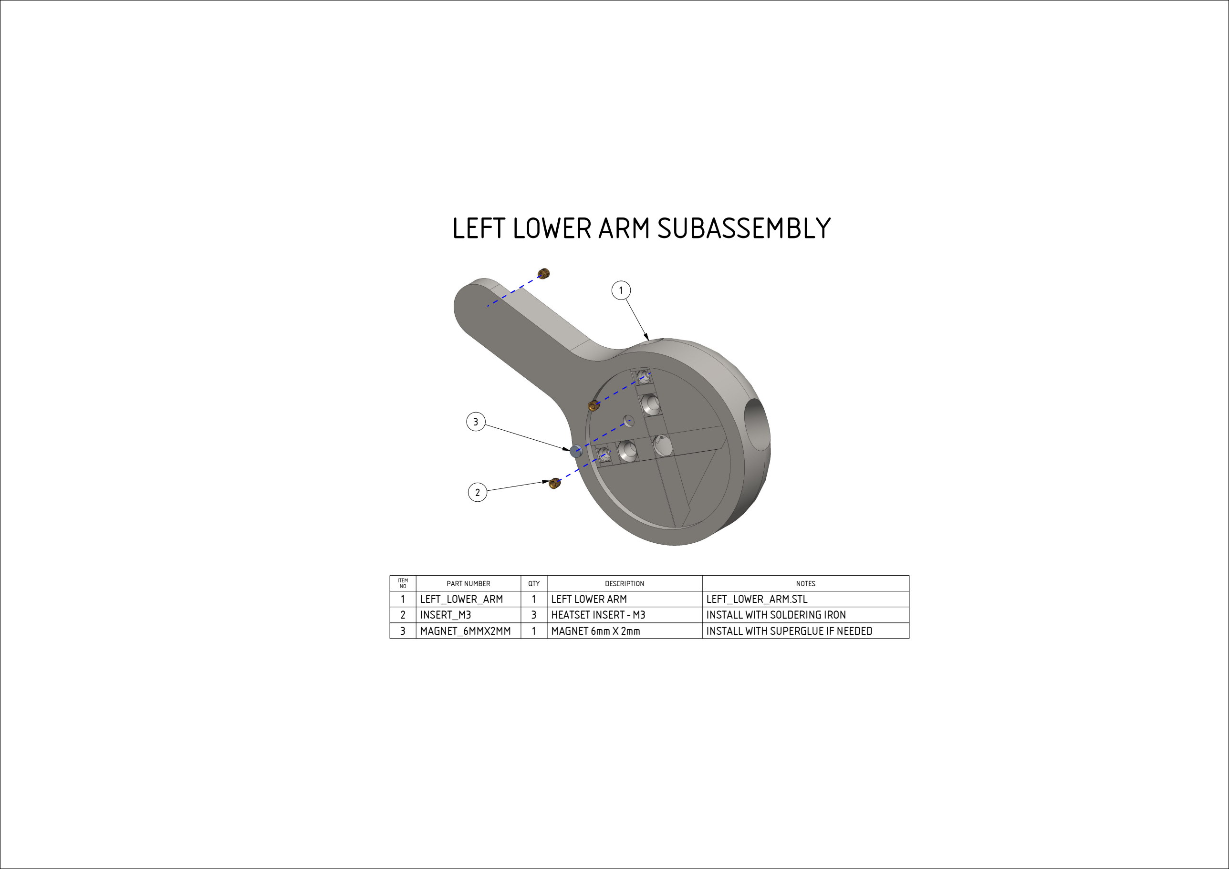
[picture p50: figure]
ITEM NO; PART NUMBER; QTY; DESCRIPTION; NOTES; LEFT_LOWER_ARM; LEFT LOWER ARM; LEFT_LOWER_ARM.STL; INSERT_M3; HEATSET INSERT - M3; INSTALL WITH SOLDERING IRON; MAGNET_6MMX2MM; MAGNET 6mm X 2mm; INSTALL WITH SUPERGLUE IF NEEDED; LEFT LOWER ARM SUBASSEMBLY
