cdn/Polyformer/Build Guide/left_upper_arm_assembly.pdf

ITEM NO | PART NUMBER | QTY | DESCRIPTION | NOTES
1 | LEFT_UPPER_ARM | 1 | LEFT UPPER ARM | LEFT_UPPER_ARM.STL
2 | BHCS_M3_12MM | 1 | BUTTON HEAD CAP SCREW - M3 X 12mm | INSTALL AS SHOWN
3 | NUT_M3 | 1 | HEX NUT - M3 | INSTALL AS SHOWN

# LEFT UPPER ARM SUBASSEMBLY

1

3 | 2
