cdn/Polyformer/Build Guide/meltzone_assembly.pdf

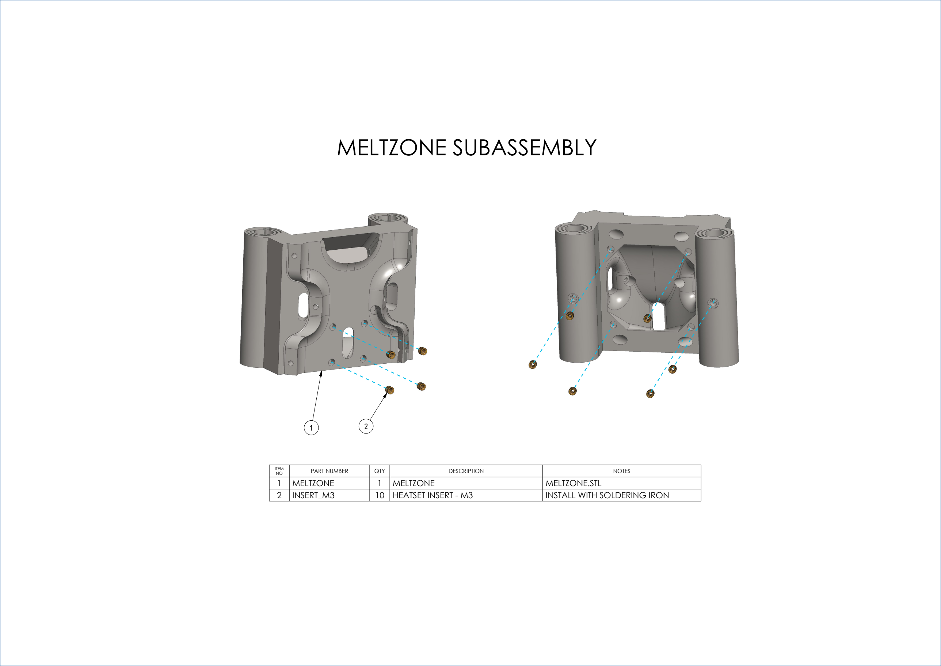
[picture p51: figure]
ITEM NO; PART NUMBER; QTY; DESCRIPTION; NOTES; MELTZONE; MELTZONE.STL; INSERT_M3; HEATSET INSERT - M3; INSTALL WITH SOLDERING IRON; MELTZONE SUBASSEMBLY
