cdn/Polyformer/Build Guide/meltzone_wing_assembly.pdf

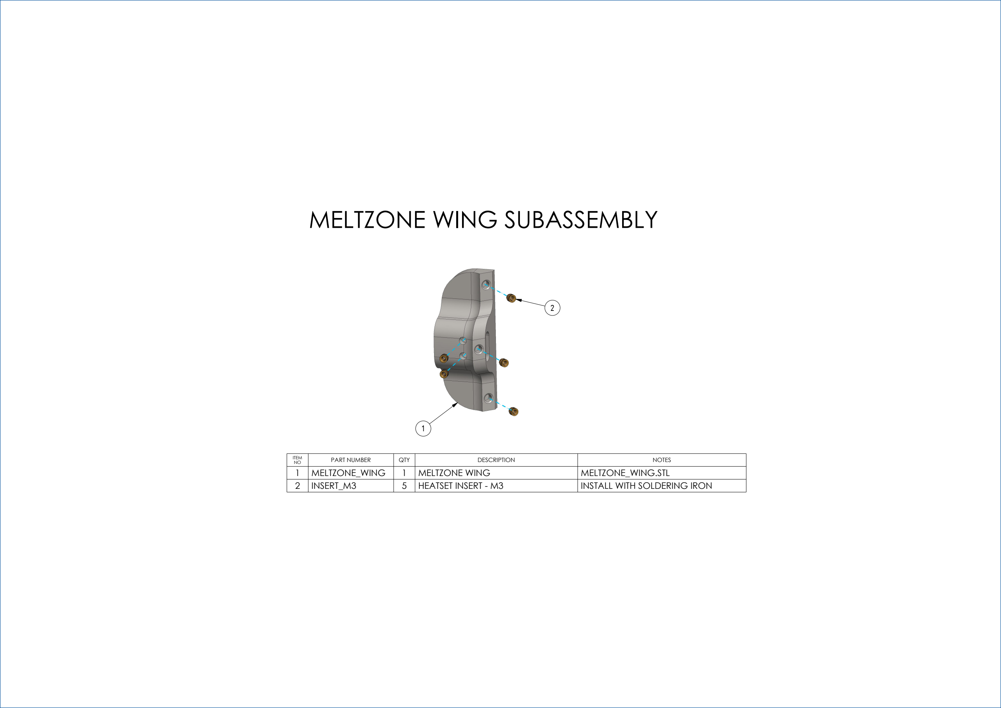
[picture p52: figure]
ITEM NO; PART NUMBER; QTY; DESCRIPTION; NOTES; MELTZONE_WING; MELTZONE WING; MELTZONE_WING.STL; INSERT_M3; HEATSET INSERT - M3; INSTALL WITH SOLDERING IRON; MELTZONE WING SUBASSEMBLY
