cdn/Polyformer/Build Guide/outlet_assembly.pdf

ITEM NO | PART NUMBER | QTY | DESCRIPTION | NOTES
1 | OUTLET | 1 | OUTLET | OUTLET.STL
2 | INSERT_M3 | 4 | HEATSET INSERT - M3 | INSTALL WITH SOLDERING IRON
3 | BHCS_M3_6MM | 2 | BUTTON HEAD CAP SCREW - M3 X 6mm | INSTALL AS SHOWN
4 | C14_PANEL_MOUNT_PLUG | 1 | C14 PANEL MOUNT PLUG | INSTALL AS SHOWN

# OUTLET SUBASSEMBLY

1

2

3 4
