cdn/Polyformer/Build Guide/panel_stabilizer_assembly.pdf

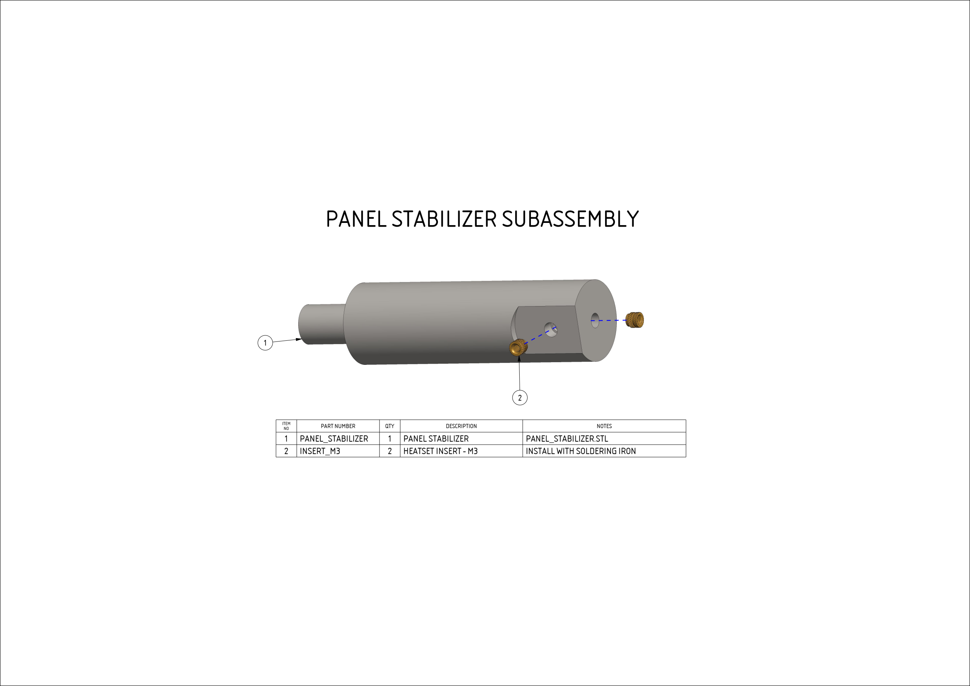
[picture p53: figure]
ITEM NO; PART NUMBER; QTY; DESCRIPTION; NOTES; PANEL_STABILIZER; PANEL STABILIZER; PANEL_STABILIZER.STL; INSERT_M3; HEATSET INSERT - M3; INSTALL WITH SOLDERING IRON; PANEL STABILIZER SUBASSEMBLY
