cdn/Polyformer/Build Guide/ribbon_cartridge_holder_assembly.pdf

ITEM NO | PART NUMBER | QTY | DESCRIPTION | NOTES
1 | RIBBON_CARTRIDGE_HOLDER | 1 | RIBBON CARTRIDGE HOLDER | RIBBON_CARTRIDGE_HOLDER.STL
2 | INSERT_M3 | 2 | HEATSET INSERT - M3 | INSTALL WITH SOLDERING IRON
3 | MAGNET_6MMX3MM | 3 | MAGNET 6mm X 3mm | INSTALL WITH SUPERGLUE IF NEEDED

# RIBBON CARTRIDGE HOLDER SUBASSEMBLY

1
3 | 2
