cdn/Polyformer/Build Guide/right_lower_arm_assembly.pdf

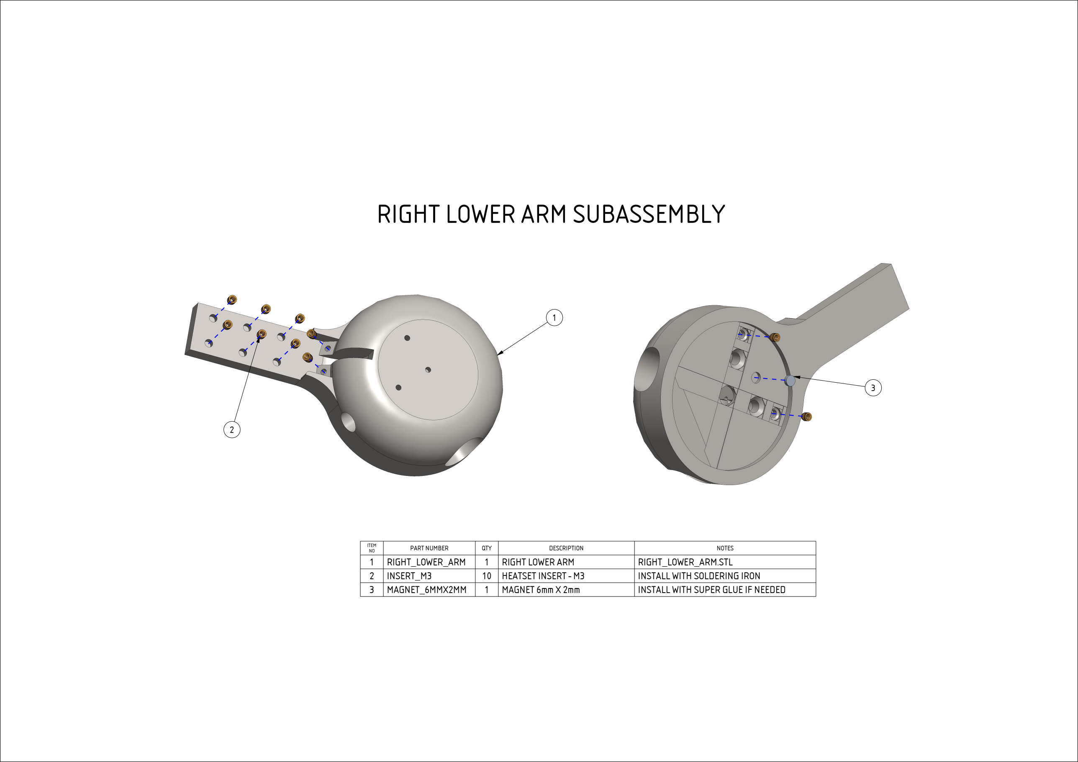
[picture p54: figure]
ITEM NO; PART NUMBER; QTY; DESCRIPTION; NOTES; RIGHT_LOWER_ARM; RIGHT LOWER ARM; RIGHT_LOWER_ARM.STL; INSERT_M3; HEATSET INSERT - M3; INSTALL WITH SOLDERING IRON; RIGHT LOWER ARM SUBASSEMBLY

3 | MAGNET_6MMX2MM | 1 | MAGNET 6mm X 2mm | INSTALL WITH SUPER GLUE IF NEEDED
