cdn/Polyformer/Build Guide/right_upper_arm_assembly.pdf

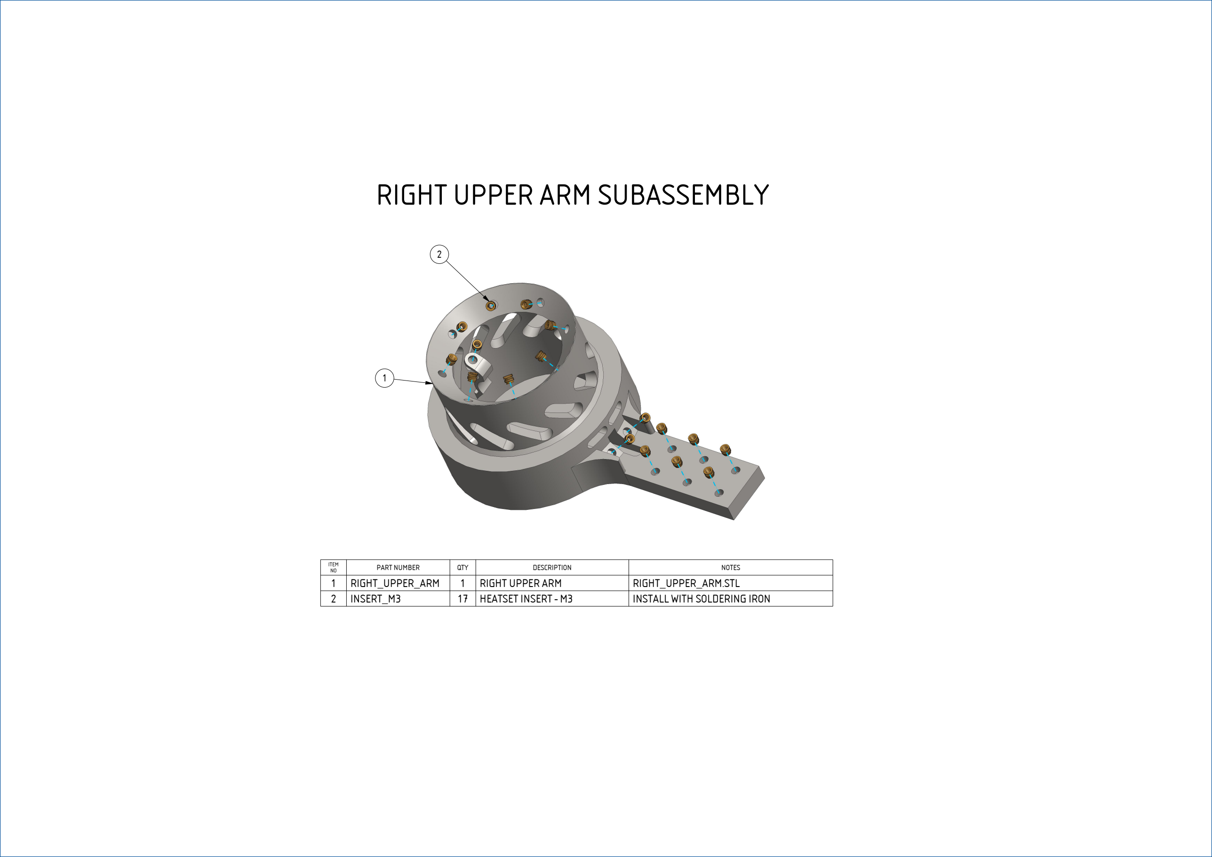
[picture p55: figure]
ITEM NO; PART NUMBER; QTY; DESCRIPTION; NOTES; RIGHT_UPPER_ARM; RIGHT UPPER ARM; RIGHT_UPPER_ARM.STL; INSERT_M3; HEATSET INSERT - M3; INSTALL WITH SOLDERING IRON; RIGHT UPPER ARM SUBASSEMBLY
