cdn/Polyformer/Build Guide/shaft_knob_assembly.pdf

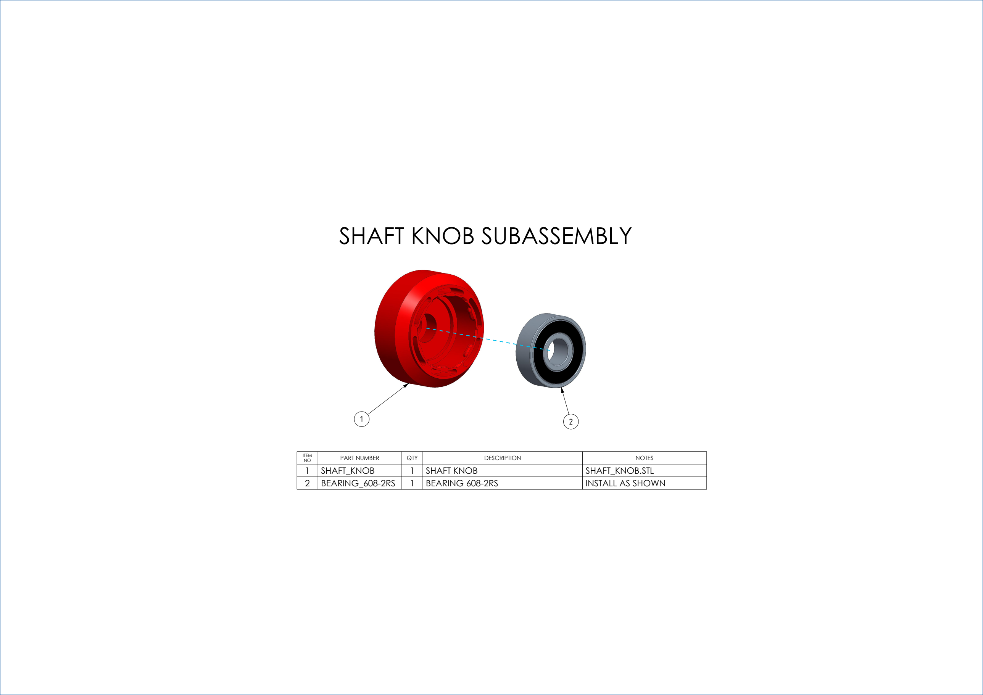
[picture p56: figure]
ITEM NO; PART NUMBER; QTY; DESCRIPTION; NOTES; SHAFT_KNOB; SHAFT KNOB; SHAFT_KNOB.STL; BEARING_608-2RS; BEARING 608-2RS; INSTALL AS SHOWN; SHAFT KNOB SUBASSEMBLY
