cdn/Polyformer/Build Guide/spool_assembly.pdf

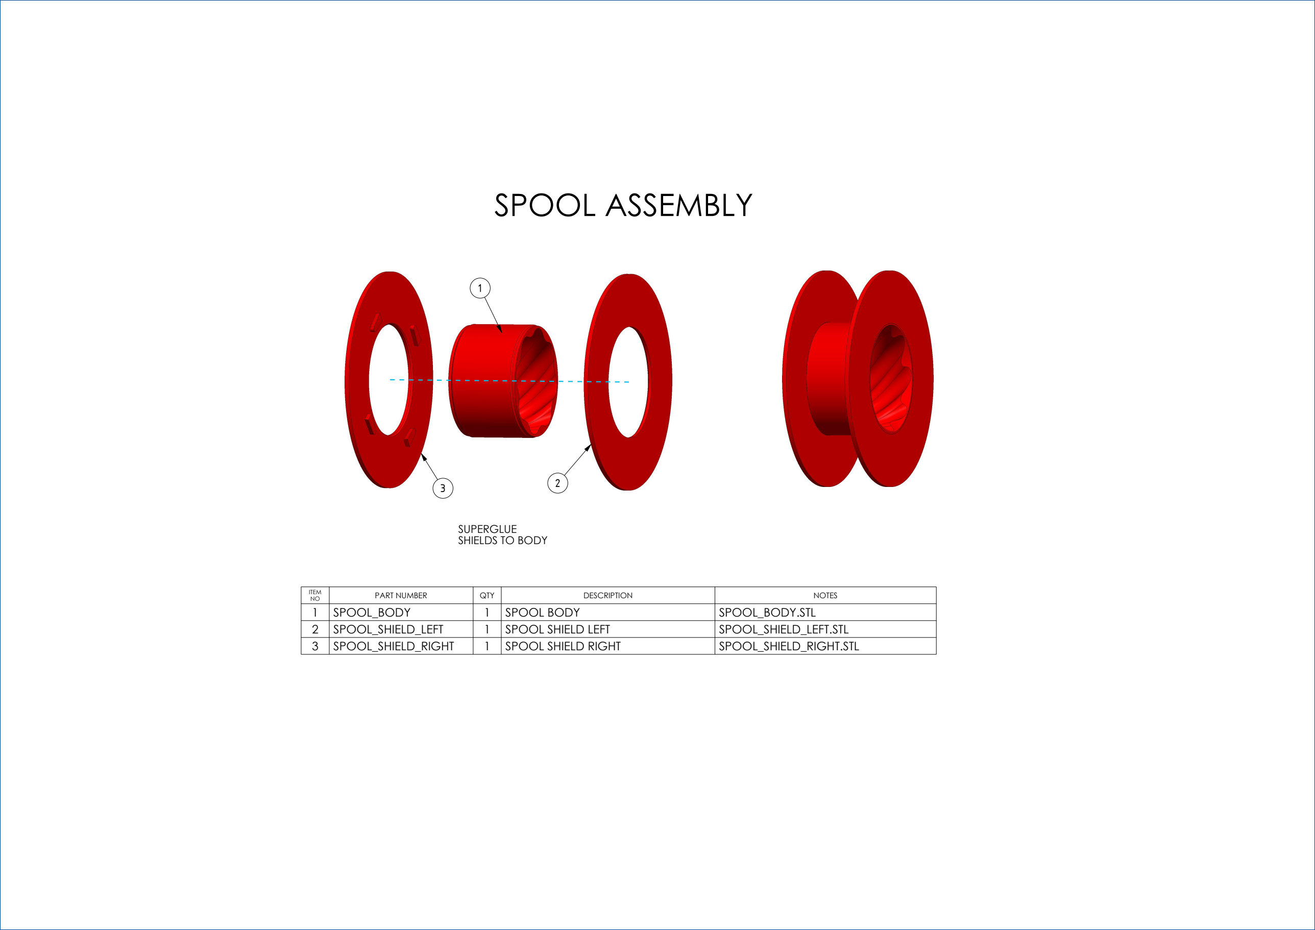
[picture p57: figure]
ITEM NO; PART NUMBER; QTY; DESCRIPTION; NOTES; SPOOL_BODY; SPOOL BODY; SPOOL_BODY.STL; SPOOL_SHIELD_LEFT; SPOOL SHIELD LEFT; SPOOL_SHIELD_LEFT.STL; SPOOL_SHIELD_RIGHT; SPOOL SHIELD RIGHT; SPOOL_SHIELD_RIGHT.STL; SPOOL ASSEMBLY; SUPERGLUE SHIELDS TO BODY
