cdn/Polyformer/Build Guide/spool_shaft_assembly.pdf

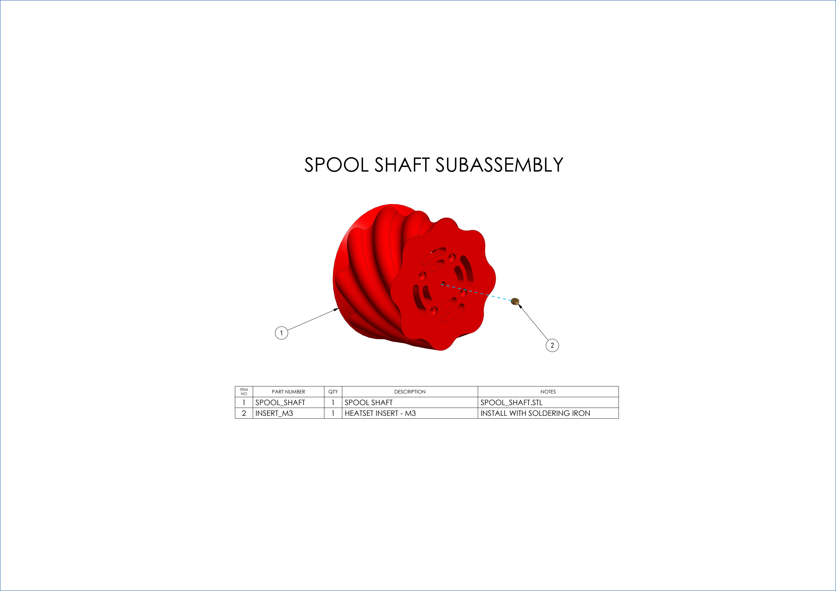
[picture p58: figure]
ITEM NO; PART NUMBER; QTY; DESCRIPTION; NOTES; SPOOL_SHAFT; SPOOL SHAFT; SPOOL_SHAFT.STL; INSERT_M3; HEATSET INSERT - M3; INSTALL WITH SOLDERING IRON; SPOOL SHAFT SUBASSEMBLY
